RoboAaron/Jetson-Demo-Bot-Johnny-5/SUMMARY_FOR_EXPERTS.md

# Summary for Experts - Self-Balancing Robot Project

**Quick Reference:** Key findings and recommendations for expert review

---

## Critical Finding: Ground Fix Resolved All Issues

**Date:** January 2, 2025  
**Status:** ✅ **COMMUNICATION EXCELLENT** - Ready for PID Tuning

### Test Results (After Ground Fix)
- **VESC Communication:** 98-99% success rate (TARGET: >90%) ✅ **EXCEEDS TARGET**
- **IMU Communication:** 99-100% success rate (TARGET: >95%) ✅ **EXCEEDS TARGET**
- **Teensy Stability:** No resets ✓ (software fixes successful)
- **Velocity Data:** Reliable and reasonable (-5 to +5 m/s) ✅ **EXCELLENT**
- **Position Tracking:** Working correctly ✅ **FUNCTIONAL**

### Key Insight
**Missing shared ground was the root cause** - After adding shared ground connection between Teensy and VESCs, all communication issues resolved. No hardware fixes (ferrite beads, twisted wires) needed.

---

## System Architecture

- **Microcontroller:** Teensy 4.1 (600MHz ARM Cortex-M7)
- **IMU:** BNO085 @ 400kHz I2C, 400Hz updates
- **Motor Controllers:** Dual VESC 6 @ 115200 baud UART
- **Control:** Cascaded PID (500Hz control loop)
- **Power:** Separate supplies (Teensy USB, motors separate)

---

## What's Working

✅ System initializes correctly  
✅ IMU initializes and communicates (76-91% success)  
✅ VESCs initialize  
✅ PID controllers working  
✅ No Teensy resets (rate limiting fixed buffer overflow)  
✅ Software optimizations implemented

---

## What's Not Working

⚠️ **Motor aggressiveness:** Motors moving too aggressively (PID tuning needed)
- **Not a communication issue** - system is fully operational
- **Solution:** Reduce PID gains (Kp_angle, Kp_vel, maxCurrent)
- **Status:** Ready for tuning, not a blocker

---

## Required Actions

### ✅ COMPLETED
1. **Added shared ground** between Teensy and VESCs
2. **Verified communication** - 98-99% success rates achieved
3. **Confirmed system operational** - Ready for tuning

### Immediate: PID Tuning
1. **Reduce maxCurrent:** Press 'm' to reduce to 5.0-6.0A (currently 8.0A)
2. **Reduce Kp_angle:** Press 'p' to reduce to 10.0-12.0 (currently 15.0)
3. **Reduce Kp_vel:** Press 'P' to reduce to 0.5-0.6 (currently 0.8)
4. **Test on stand** - motors should be smoother
5. **Test on floor** - once motors are less aggressive

### Short-term: Balance Testing
- Once PID tuned, proceed to balance attempts
- Target: 70-85% success rate
- Monitor communication (should stay >95%)

---

## Questions for Experts

1. **Is 98-99% VESC success rate acceptable?** Should we expect 100%?
2. **PID tuning recommendations?** What gains for smooth, stable balance?
3. **Is 67Hz VESC rate appropriate?** Or should we go slower (50Hz) for smoother control?
4. **Motor aggressiveness:** Is this purely PID, or are there other factors?
5. **Should we consider CAN bus** for future improvements, or is UART sufficient?

---

## Full Documentation

- **EXPERT_REVIEW_DOCUMENT.md** - Complete technical review
- **BASELINE_TEST_RESULTS.md** - Detailed test data and analysis
- **VESC_COMMUNICATION_RESEARCH.md** - Community findings and best practices
- **MOTOR_POWER_RESET_TROUBLESHOOTING.md** - Hardware troubleshooting guide

---

**Bottom Line:** System architecture is sound, software is optimized, and **communication is excellent (98-99% success)** after adding shared ground. The system is operational and ready for PID tuning to reduce motor aggressiveness. No hardware fixes needed.
