RoboAaron/Jetson-Demo-Bot-Johnny-5/teensy_balance_single_loop/LAST_WORKING_CONFIG.md

# ⚠️ LAST WORKING CONFIGURATION - DO NOT MODIFY

## Status: EXCELLENT BALANCE PERFORMANCE ✅

**Date:** 2026-01-23 17:34:38  
**Log File:** `tuning_code/logs/robot_log_20260123_173438.txt`  
**Firmware:** `teensy_balance_single_loop/teensy_balance_single_loop.ino` (before yaw control interference)

---

## Performance Metrics

- **Roll Stability:** -0.25° to -0.7° (target: -0.7°) - **EXCELLENT** (±0.5°)
- **Motor Current:** -1.0A to +1.0A - **SMOOTH, CONTROLLED**
- **IMU Communication:** 97.7-98.8% success rate - **EXCELLENT**
- **No Oscillations:** Roll varies smoothly, no chattering
- **Response to Disturbances:** Smooth corrections in 1-2 seconds

**VERDICT:** ✅ **READY FOR VELOCITY CONTROL**

---

## Tuning Values (WORKING)

```
ROLL PID CONTROL (Balance):
  Kp: 1.50
  Ki: 0.00
  Kd: 0.03
  Base Angle Setpoint: -0.70°
  Drive Offset: 0.00°
  Active Setpoint: -0.70°

MOTOR CONTROL:
  Max Current: 6.50A
  Min Current: 0.30A
  Motor Direction Sign: 1.0

SYSTEM CONFIG:
  I2C Clock: 400 kHz
  IMU Rate: 400 Hz
  PID Rate: 500 Hz
  Control Mode: PID
```

---

## Yaw Control Status

**Yaw control was DISABLED (corrupted values = -nan, output = 0.00A)**

This is why balance worked perfectly - yaw control was not interfering.

---

## Key Differences from Current Broken Version

1. **Yaw Output:** 0.00A (disabled) vs 6.50A (maxed out, fighting balance)
2. **Yaw Control:** Disabled vs Enabled with aggressive gains
3. **Balance:** Stable vs Unstable (robot falling over)

---

## How to Restore This Configuration

1. **Disable yaw control:**
   ```cpp
   bool yawControlEnabled = false;  // Change from true to false
   ```

2. **Set yaw gains to 0:**
   ```cpp
   double Kp_yaw = 0.0;
   double Ki_yaw = 0.0;
   double Kd_yaw = 0.0;
   ```

3. **Or use the 'n' command** to toggle yaw control off

4. **Restore balance PID values:**
   ```cpp
   double Kp = 1.50;
   double Ki = 0.00;
   double Kd = 0.03;
   double baseSetpoint = -0.70;
   float maxCurrent = 6.50;
   ```

---

## Notes

- This configuration achieved **excellent balance performance**
- Robot balanced consistently on stand for 30+ seconds
- All readiness criteria were met
- **This is the baseline to build from for velocity control**

**DO NOT modify this configuration unless you have a specific reason and have tested thoroughly.**
