RoboAaron/Jetson-Demo-Bot-Johnny-5/teensy_balance_single_loop/READINESS_CHECKLIST.md

# Readiness Checklist: When to Add Velocity Control

## Quick Answer

**You need "Good Enough" stability, not perfection.** The angle PID should be **stable and responsive**, but it doesn't need to be perfectly tuned. You can fine-tune everything together once velocity control is added.

**Minimum Requirements**: ✅ All items in "Must Have" section  
**Recommended**: ✅ All items in "Must Have" + "Should Have" sections  
**Ideal**: ✅ All items (but not required to proceed)

---

## Must Have (Required Before Velocity Control)

### 1. ✅ Robot Balances on Stand
- **Test**: Place robot on stand, let go
- **Pass**: Robot holds position for **30+ seconds** without falling
- **Fail**: Robot falls over or requires constant intervention
- **Why**: If it can't balance in place, adding velocity will make it worse

### 2. ✅ Responds to Disturbances
- **Test**: Gently push robot forward/backward on stand
- **Pass**: Robot corrects and returns to upright within **2-3 seconds**
- **Fail**: Robot doesn't respond or oscillates wildly
- **Why**: Velocity control will add disturbances; robot must handle them

### 3. ✅ No Wild Oscillations
- **Test**: Watch roll angle in GUI while balanced
- **Pass**: Roll angle varies by **±2° or less** when stable
- **Fail**: Roll angle oscillates ±5°+ or motor current oscillates rapidly
- **Why**: Oscillations will amplify with velocity control

### 4. ✅ Smooth Motor Response
- **Test**: Watch motor current in GUI
- **Pass**: Current changes smoothly, no rapid on/off switching
- **Fail**: Current jumps between max/min rapidly (chattering)
- **Why**: Velocity control needs smooth base to work with

### 5. ✅ Correct Direction
- **Test**: Tilt robot forward → wheels spin forward
- **Pass**: Robot moves in correct direction when tilted
- **Fail**: Robot moves wrong direction
- **Why**: Wrong direction will cause instability

---

## Should Have (Recommended but Not Required)

### 6. ✅ Recovers from Large Tilts
- **Test**: Tilt robot 10-15° and release
- **Pass**: Robot recovers to upright within 3-5 seconds
- **Fail**: Robot can't recover or takes >10 seconds
- **Why**: Velocity control may cause larger tilts during acceleration

### 7. ✅ Stable Current When Balanced
- **Test**: Watch current when robot is upright
- **Pass**: Current stays below **2-3A** when stable
- **Fail**: Current stays high (>4A) even when balanced
- **Why**: High current indicates over-correction or wrong setpoint

### 8. ✅ Minimal Overshoot
- **Test**: Tilt robot and release
- **Pass**: Robot returns to upright with <2° overshoot
- **Fail**: Robot overshoots by 5°+ or oscillates
- **Why**: Overshoot will cause velocity control to over-correct

---

## Nice to Have (Optional)

### 9. ✅ Works on Floor
- **Test**: Balance robot on floor (with safety measures)
- **Pass**: Robot balances for 10+ seconds on floor
- **Fail**: Robot only works on stand
- **Why**: Floor balancing is harder; if it works, you're ready

### 10. ✅ Handles Yaw Rotation
- **Test**: Robot doesn't spin when balancing
- **Pass**: Yaw stays within ±5° when balancing
- **Fail**: Robot rotates continuously
- **Why**: Yaw control should be working before adding velocity

---

## What Happens If You Add Velocity Too Early?

### Scenario 1: Unstable Base (Fails "Must Have" #1-3)
**Result**: 
- Robot becomes completely unstable
- Velocity control amplifies existing oscillations
- Robot falls immediately when velocity command given
- **Solution**: Go back and fix angle PID first

### Scenario 2: Chattering Motors (Fails "Must Have" #4)
**Result**:
- Velocity control adds more chattering
- Motors oscillate between forward/backward rapidly
- Robot shakes violently
- **Solution**: Reduce angle PID gains, add more damping

### Scenario 3: Wrong Direction (Fails "Must Have" #5)
**Result**:
- Velocity commands make robot more unstable
- Robot accelerates in wrong direction
- Falls immediately
- **Solution**: Fix motor direction first

---

## Practical Test Protocol

### Test 1: Stand Stability (5 minutes)
1. Place robot on stand
2. Let go and observe for 30 seconds
3. **Pass if**: Robot stays upright, roll angle ±2°
4. **Fail if**: Robot falls or oscillates wildly

### Test 2: Disturbance Response (5 minutes)
1. Gently push robot forward
2. Release and observe recovery
3. **Pass if**: Returns to upright in 2-3 seconds
4. **Fail if**: Doesn't recover or oscillates

### Test 3: Motor Smoothness (2 minutes)
1. Watch GUI current graph
2. Observe while robot is balanced
3. **Pass if**: Current changes smoothly, no rapid switching
4. **Fail if**: Current jumps rapidly (chattering)

### Test 4: Direction Test (1 minute)
1. Tilt robot forward
2. Observe wheel direction
3. **Pass if**: Wheels spin forward
4. **Fail if**: Wheels spin backward

**Total Time**: ~15 minutes

---

## Current Status Assessment

Based on your recent testing:

### ✅ Likely Ready If:
- Robot balances on stand for 30+ seconds
- Yaw control is working (prevents rotation)
- Motor current is reasonable (<3A when stable)
- No major oscillations observed

### ⚠️ Needs More Tuning If:
- Robot falls over on stand
- Motor chattering observed
- Large oscillations (±5°+)
- Can't recover from small pushes

### ❌ Not Ready If:
- Robot doesn't balance at all
- Motors go wrong direction
- Wild oscillations or shaking
- Can't even hold position on stand

---

## The "Good Enough" Threshold

**Key Insight**: You don't need perfect tuning. You need:
1. **Stability**: Robot doesn't fall over
2. **Responsiveness**: Robot corrects disturbances
3. **Smoothness**: No wild oscillations

**Why "Good Enough" Works**:
- Velocity control will actually **help** stability (provides smooth acceleration)
- You can tune angle and velocity loops together
- Perfect angle tuning may not work well with velocity anyway
- Industry practice: Tune cascaded loops together, not separately

---

## Recommended Approach

### Option A: Conservative (Recommended)
1. Get angle PID stable on stand (30+ seconds)
2. Add velocity control with very low gains (Kp_vel = 0.1)
3. Tune both loops together
4. Gradually increase velocity gains

### Option B: Aggressive
1. Get angle PID "good enough" (15-20 seconds stable)
2. Add velocity control immediately
3. Tune everything together from the start

**Recommendation**: Option A is safer, but Option B can work if you're confident.

---

## What to Watch For After Adding Velocity

### Good Signs:
- Robot balances with velocity = 0
- Robot moves smoothly when velocity > 0
- No new oscillations introduced
- Recovery from disturbances still works

### Bad Signs:
- Robot becomes less stable than before
- New oscillations appear
- Can't balance even with velocity = 0
- Motors chatter more

**If Bad Signs**: Reduce velocity gains or go back to angle-only tuning

---

## Bottom Line

**Minimum to Proceed**:
- ✅ Robot balances on stand (30+ seconds)
- ✅ Responds to disturbances
- ✅ No wild oscillations
- ✅ Smooth motor response
- ✅ Correct direction

**You DON'T need**:
- ❌ Perfect floor balancing
- ❌ Zero overshoot
- ❌ Perfect setpoint
- ❌ Optimal gains

**Time Estimate**:
- If robot is already balancing: **Ready now** ✅
- If needs tuning: **1-2 hours** to get to "good enough"
- If major issues: **4-6 hours** to fix fundamentals

---

## Next Steps

1. **Run the 4 tests above** (15 minutes)
2. **If all pass**: You're ready for Phase 1 (Velocity Control)
3. **If some fail**: Fix those issues first (1-2 hours)
4. **If many fail**: Go back to basics (4-6 hours)

**Remember**: "Good enough" is good enough. You can always tune more later!
