RoboAaron/Jetson-Demo-Bot-Johnny-5/docs/delivery/4/4-10.md

# [4-10] Traction Surface Retune + Optional Plant ID

**Parent**: [Tasks for PBI 4](./tasks.md)

## Description

Re-run Phase A tuning on a representative high-traction floor (not cardboard). Optionally log commanded motor current vs wheel ERPM / derived acceleration for a simple static/dynamic friction and thrust map to inform `maxCurrent` and velocity-loop limits.

## Status History

- 2026-04-16: Created as **Proposed** (roadmap Phase C).

## Requirements

1. Document test surface and date in log filename or header note.
2. Establish safe `maxCurrent` for that surface without chronic wheel slip.
3. Optional: short script or checklist for step-response logging at 0.5 / 1.0 / 1.5 / 2.0 A.

## Implementation Plan

Operator-led tuning; firmware changes only if new telemetry fields are needed.

## Test Plan

30 s quiet hold + impulse recovery on target surface; compare to cardboard baseline.

## Verification

Pending.

## Files Modified

None expected unless telemetry added.
