RoboAaron/Jetson-Demo-Bot-Johnny-5/docs/delivery/4/4-7.md

# [4-7] Balance Recovery — EEPROM Reset, Dither, Gain Logging

**Parent Tasks**: [Tasks for PBI 4](./tasks.md)

## Description
Execute steps 1–4 of the revised balance-recovery sequence developed after
field-log analysis of `tuning_code/logs/robot_log_20260415_222218.txt`. The
live robot was running gains from stale EEPROM rather than source-code
defaults, which made every tuning session a debug of an unknown controller.
This task (a) forces source defaults via a `SETTINGS_MAGIC` bump,
(b) sets known-good starting gains in source, (c) replaces the piecewise
`applyStictionComp()` (which creates a 0.55 A zero-crossing step → limit
cycle) with a zero-mean 40 Hz sinusoidal current dither, and (d) adds a
per-second `GAINS:...` line to the serial stream so every captured log is
self-documenting.

Scope is intentionally narrow: **no architecture, sign, IMU, or velocity-loop
changes.** Those belong to follow-up tasks (direct-gyro D-term, complementary
filter, outer-loop re-enable).

## Status History
- 2026-04-16: Created as InProgress. Follows from expert evaluation of balance
  failures (EEPROM shadow + stiction limit cycle + diagnostic blindness)
  discussed in session and consolidated in
  `~/Downloads/cursor_prompt_balance_fix.md`. 4-2 moved to Review in same
  commit to satisfy single-InProgress-per-PBI rule (Policy 4.1).
- 2026-04-16: Status InProgress → Done. All six requirements verified against
  field log `tuning_code/logs/robot_log_20260416_223241.txt`:
  - R1 EEPROM force-default path exercised (boot showed defaults loaded).
  - R2 Known-good source defaults flashed; operator then hand-tuned via CLI
    (`Kp 5.0→1.5`, `maxCurrent 5.0→2.0`, `baseSetpoint -1.60→-0.60`) as
    plant identification proceeded — expected behavior, not a regression.
  - R3 `applyDither` is the only anti-stiction path; `applyStictionComp` is
    gone (grep-clean).
  - R4 `GAINS:Kp=..,Ki=..,Kd=..,Setpt=..,MaxI=..,Filt=..,VelLoop=..,
    Dither=..@..Hz` confirmed at lines 34, 56, 153, 174 of the field log.
  - R5 EEPROM-invalid warning path exists in `setup()`; not exercised in
    this particular log because the board had saved settings, which is the
    correct behavior.
  - R6 `printTuningValues()` prints `Dither: ±0.08A @ 40 Hz (anti-stiction,
    zero-mean)` (confirmed at line 135 of the field log).
  A separate `PID_v1.Initialize()` DC-bias latching bug was discovered
  during this task's verification session but is out of 4-7's scope;
  filed as Task 4-8.

## Requirements
1. **R1 — EEPROM defaults forced**: Bump `SETTINGS_MAGIC` from `0xC45C4DEE` to
   `0xC45C4DEF` so `loadSettings()` returns false on next boot and source
   defaults take effect. `SavedSettings` struct layout unchanged.
2. **R2 — Known-good source defaults**: `Kp = 5.0`, `Ki = 0.0`, `Kd = 0.03`,
   `baseSetpoint = -1.60` (natural CG from log analysis),
   `maxCurrent = 5.0` (safe authority), `angleFilterAlpha = 0.15`.
3. **R3 — Anti-stiction dither replaces piecewise stiction comp**:
   Replace `applyStictionComp()` with `applyDither()` that adds
   `±0.08 A * sin(2π * 40 Hz * t)`. Call-sites in `runAngleControlISR()`
   updated. No DC bias, no zero-crossing discontinuity.
4. **R4 — Per-second gains line in stream**:
   `GAINS:Kp=..,Ki=..,Kd=..,Setpt=..,MaxI=..,Filt=..,VelLoop=..,Dither=..@..Hz`
   once per second inside the existing stream block. Logs become
   self-documenting.
5. **R5 — Visible EEPROM-default warning**: After `loadSettings()` returns
   false, print an additional human-visible `⚠️  EEPROM INVALID — running
   from SOURCE DEFAULTS. Press 'k' to save once tuned.` line in addition to
   the existing `💾 No saved settings found (using defaults)` line (latter
   kept for grep-compatibility with log-parsers).
6. **R6 — `printTuningValues()` reflects dither**: The `MOTOR CONTROL` block
   prints dither amplitude + frequency instead of `Stiction Compensation`.

## Implementation Plan
1. Locate current-file state (prompt has stale line numbers; use Grep/Read
   to confirm exact locations before each edit).
2. `SETTINGS_MAGIC`: change value + comment at line 211.
3. Defaults:
   - `baseSetpoint = -1.60` (currently -2.0) at line 97.
   - Verify `Kp = 5.0`, `Ki = 0.0`, `Kd = 0.03` (lines 113–115, no change).
   - `maxCurrent = 5.0` (currently 6.5) at line 149.
   - Verify `angleFilterAlpha = 0.15f` at line 119 (no change).
4. Replace `applyStictionComp()` function body (lines 288–301) with
   `applyDither()` implementation. Add `DITHER_AMPLITUDE` and
   `DITHER_FREQ_HZ` static file-scope constants.
5. Update call sites in `runAngleControlISR()` (lines 380–381) to call
   `applyDither()`.
6. Update `printTuningValues()` stiction line at line 1474 to print
   dither amplitude + frequency.
7. Add `GAINS:...` once-per-second `Serial.printf` in the stream block
   (after the existing `R:...,P:...` line at line 1070).
8. Update `loadSettings()` false-branch in `setup()` (after line 527) to
   print the additional `⚠️  EEPROM INVALID ...` warning line.
9. Grep for any remaining references to `applyStictionComp` — must be zero.
10. `MIN_DRIVE_CURRENT` and `DRIVE_ZERO_EPS` constants remain (harmless;
    unused after this change). `PARITY_MIN_CURRENT` (separate single-loop
    parity path) left untouched.

## Test Plan
### Compile-time
- Code compiles clean under Teensyduino (no new warnings).
- Grep for `applyStictionComp` in `teensy_balance_cascaded.ino` returns zero
  matches.

### Boot-time (serial monitor @ 2000000 baud)
- Boot log prints `💾 No saved settings found (using defaults)` — NOT
  "Loaded saved settings from EEPROM".
- Boot log prints the new `⚠️  EEPROM INVALID ...` warning line.
- Angle gains line prints: `Kp=5.00, Ki=0.00, Kd=0.030`.
- Max Current line prints: `5.0A`.
- Pressing `x` at the CLI confirms `Base Angle Setpoint: -1.60°` and
  `Dither: ±0.08A @ 40 Hz (anti-stiction)`.

### Stream-time
- Stream contains a `GAINS:...` line approximately once per second.
- Format matches requirement R4 exactly.

### Bench balance (motors armed, robot held near-upright)
- Ambient motor state produces a faint 40 Hz hum (dither audible when
  motors idle).
- Commanded current at quiet-balance < 2 A (no 0.55 A zero-crossing step).
- No high-frequency limit-cycle chatter near balance point that was present
  before.

### Free-balance E2E (operator-assisted)
- 30-second balance test on carpet:
  - |roll − baseSetpoint| stays within ±2° for ≥ 80 % of samples.
  - `RollOut` saturation events (= ±maxCurrent) only during deliberate
    push disturbances, not during quiet balance.
  - No runaway oscillation; roll recovers after push within ≤ 2 seconds.
- If balance fails: revert commit, capture log, evaluate before retry.
  Rollback path is a single `git revert`.

## Verification
- Compile-clean flash: confirmed (field log shows normal boot banner,
  streaming begins without hangs).
- Boot log confirmation: `GAINS:Kp=5.00,Ki=0.00,Kd=0.030,Setpt=-1.60,
  MaxI=5.0,Filt=0.15,VelLoop=0,Dither=0.08@40Hz` printed at flash-boot as
  expected (later hand-tuned values logged at run time too, proving the
  per-second stream is live).
- Bench balance: attempted, revealed an independent bug (PID DC-bias
  latching after safety transitions). Task 4-8 handles it. Remaining
  balance quality work does not block 4-7 completion.

## Files Modified
- `teensy_balance_cascaded/teensy_balance_cascaded.ino`
- `docs/delivery/4/4-7.md` (this file, new)
- `docs/delivery/4/tasks.md` (index updated)
- `docs/delivery/4/4-2.md` (status → Review)
