RoboAaron/Jetson-Demo-Bot-Johnny-5/docs/delivery/4/4-2.md

# [4-2] Fix Velocity Loop Sign and Deadband Issues

## Description
Fix critical issues in the cascaded velocity control loop: incorrect PID sign causing positive feedback, deadband logic thrashing PID modes, and missing input clamping.

## Status History
- 2026-01-26: Created as InProgress - fixing velocity loop sign and deadband mode thrashing
- 2026-02: Velocity sign verified correct for our VESC (no VEL SIGN MISMATCH). Deadband thrashing fixed via state flag (see TUNING_RECOMMENDATIONS.md "Deadband thrashing (fixed)").
- 2026-04-15: Extended scope to implement Phase 1 Step 2 from `velocity_estimation_plan.pdf` (IMU pitch-rate velocity estimator routed to velocity PID input). Task remains InProgress.
- 2026-04-15: Extended scope to cover BNO085 reboot/power-cycle recovery. Field logs showed full-rate updates after flash boot, but reboot/power-cycle fell into a weaker `wasReset()` recovery path that only re-enabled reports and produced much slower effective update delivery. Recovery now re-applies report configuration after `wasReset()` with the same settle + second-enable timing as startup, without calling `begin_I2C()` from `loop()` (which can strand I2C). The startup `ignoreNextImuReset` path must also re-enable reports: consuming `wasReset()` alone drops subscriptions until `enableReport` runs again.
- 2026-04-16: Status InProgress → Review. All requirements met: velocity PID sign correct (REVERSE + verification print), deadband mode thrashing fixed (state flag), input clamping added, debug print sign corrected, BNO085 reboot/power-cycle recovery verified working. Remaining inner-loop EEPROM-gain-shadow problem and stiction-comp limit-cycle are not part of this task's scope; moved to new Task 4-7 (Balance Recovery). Pending final operator verification on a full balance session before Review → Done.

## Requirements
1. **Fix Velocity PID Sign**: Change from DIRECT to REVERSE mode to correct control direction
2. **Fix Deadband Mode Thrashing**: Stop toggling MANUAL/AUTOMATIC every 50ms - use state flag
3. **Add Input Clamping**: Clamp velocityInput to prevent garbage values from saturating loop
4. **Fix Debug Print Sign**: Correct velocity error calculation (setpoint - input, not input - setpoint)
5. **Add Sign Verification Print**: Clear debug output to verify correct behavior after fix
6. **Fix Reboot/Power-Cycle IMU Recovery**: After `wasReset()`, restore the same full-rate BNO085 startup behavior seen after flash upload

## Implementation Plan
1. Change velocity PID initialization from `DIRECT` to `REVERSE`
2. Add `static bool deadbandActive = false;` state flag
3. Replace deadband block with state-based logic:
   - Enter deadband once: Set MANUAL mode, zero output
   - Exit deadband once: Set AUTOMATIC mode, re-initialize
4. Add `velocityInput = constrain(velocityInput, -2.0, 2.0);` before Compute()
5. Fix debug print: `float velocityError = velocitySetpoint - filteredVelocity;`
6. Add sign verification print at 1Hz showing setpoint, filteredVelocity, angleFromVel
7. On every `wasReset()` (including the expected post-startup reset), call `enableIMUReports()` again after delays so SH2_RESET does not leave the hub with no rotation-vector subscription; do not call `begin_I2C()` from `loop()`

**How deadband thrashing is fixed:** Thrashing happened when the code toggled MANUAL/AUTOMATIC every 20 ms based on whether we were inside or outside the velocity deadband, which reset the PID integral and caused unstable behavior. The fix is to **transition only once** in each direction: when we first enter deadband (setpoint ≈ 0 and |velocity| < 0.08 m/s), set `deadbandActive = true`, call `SetMode(MANUAL)`, and zero the angle-from-velocity output; while in deadband do not call the PID. When we leave (setpoint non-zero or velocity outside deadband), set `deadbandActive = false` and `SetMode(AUTOMATIC)` once, then run the velocity PID as normal. See `teensy_balance_cascaded/TUNING_RECOMMENDATIONS.md` section "Deadband thrashing (fixed)" and firmware around the 20 Hz velocity PID block.

## Plan Change Log (Velocity Estimation Plan vs Implementation)

### Applied from plan
1. Added IMU velocity estimator path (Option A): pitch-rate integration with decay and clamping.
2. Routed outer-loop `velocityInput` from IMU estimate (replacing VESC-derived filtered velocity for control).
3. Added runtime `VEL_SCALE` tuning commands (`n`/`N`) for live scale calibration.
4. Kept VESC reads in background for diagnostics and comparison.

### Deviations from original plan and rationale
1. **Gyro rate reduced from 400Hz to 100Hz** (`GYRO_REPORT_INTERVAL_US = 10000`):
   - Rationale: reduced I2C bus pressure and improved startup robustness observed in-field.
2. **`dt` sanity window widened from `<0.01` to `<0.03` seconds** in estimator:
   - Rationale: at 100Hz, nominal sample period is ~0.01s and can jitter above 10ms; strict `<0.01` would drop valid updates.
3. **VESC signal kept visible in debug prints while control uses IMU velocity**:
   - Rationale: enables side-by-side validation and rollback confidence without reintroducing VESC noise into the control path.
4. **Motor command dispatch remains outside ISR** (prior structural change retained):
   - Rationale: avoids UART write contention and streaming stalls discovered during previous ISR-based write attempts.
5. **`wasReset()` recovery re-applies report configuration (double enable with settle delays), not `begin_I2C()` in `loop()`**:
   - Rationale: after `SH2_RESET`, report subscriptions are cleared; the code must call `enableReport` again or no rotation vectors arrive (`imuReadCount` stays 0). A brief attempt to run `begin_I2C()` from `loop()` after a bad `wasReset()` handling caused I2C probe failures (`I2C address not found`). The fix is to keep the SHTP session open and only re-send sensor config, matching startup timing without an extra transport teardown in `loop()`.

## Test Plan
1. **Sign Verification**: With velocitySetpoint = 0, angleSetpointFromVel should sit at ~0 (no constant +0.5° saturation)
2. **Positive Velocity**: Command +velocity, verify angleFromVel moves in direction that reduces (setpoint - velocity) error
3. **Deadband Stability**: Verify PID mode doesn't toggle constantly when in deadband
4. **Input Clamping**: Verify garbage velocity values don't cause instant saturation
5. **Reboot Recovery**: After hardware reset or power cycle, verify `wasReset()` paths print re-enable success and status lines resume at the normal ~50 ms stream cadence rather than multi-second gaps; confirm no `I2C address not found` after flash boot

## Verification
- Velocity loop responds correctly to setpoint changes
- No mode thrashing in deadband
- Input values stay within reasonable bounds
- Debug output shows correct signs
- Reboot/power-cycle: `wasReset()` always re-enables reports (including startup-ack path); no `begin_I2C()` from `loop()`

## Files Modified
- `teensy_balance_cascaded/teensy_balance_cascaded.ino`
- `docs/delivery/4/4-2.md`

**Parent Tasks**: [Tasks for PBI 4](./tasks.md)
