RoboAaron/Jetson-Demo-Bot-Johnny-5/docs/delivery/4/4-4.md

# [4-4] Implement Sensor Fusion

## Description
Improve angle estimation by fusing IMU data (e.g. complementary filter or Kalman) on the Teensy, if needed. BNO085 already provides onboard fusion; this task is for any additional fusion (e.g. with VESC velocity) or if switching to raw gyro/accel is desired.

## Status History
- 2026-02: Task file created; scope from PBI-4 prd.

## Requirements
1. Assess whether BNO085 fused output is sufficient (current: 400 Hz I2C).
2. If improved fusion is needed: implement complementary or Kalman filter combining gyro and accel (or BNO085 output with velocity) per BALANCE_CODE_REVIEW and literature.
3. Document fusion choice and parameters.

## Implementation Plan
1. Review current BNO085 usage and PATH_TO_99_PERCENT_RELIABILITY.md.
2. If proceeding: add filter in firmware; tune; compare balance stability vs current.
3. Document in firmware and/or docs.

## Test Plan
1. Compare balance stability and drift with/without new fusion.
2. Log roll variance and recovery time.

## Verification
- Angle estimate stable and low drift; no regression in balance success.
- Documented in PBI-4 prd and firmware.

## Files Modified
- `teensy_balance_cascaded/teensy_balance_cascaded.ino` (if implemented)
- Docs as needed

**Parent**: [Tasks for PBI 4](./tasks.md)
