RoboAaron/Jetson-Demo-Bot-Johnny-5/docs/delivery/4/4-E2E.md

# [4-E2E] E2E CoS Test for PBI-4

## Description
End-to-end verification that PBI-4 Conditions of Satisfaction are met: stable balance, velocity control without breaking balance, and documented tuning and test results. No SPI dependency.

## Status History
- 2026-02: Task file created; scope from PBI-4 tasks index.

## Requirements
1. **Phase 1 cascaded control**: Balance with velocity setpoint 0 is stable; velocity loop can be used without breaking balance (per PBI-4 CoS).
2. **Velocity loop**: Sign and deadband issues resolved (4-2); tuning stable (4-3).
3. **Testing**: 4-6 completed; results documented.
4. **Optional**: Sensor fusion (4-4), velocity damping (4-5) if in scope for this release.

## Implementation Plan
1. Run full test suite from 4-6.
2. Confirm all PBI-4 CoS from backlog/prd are either met or explicitly deferred.
3. Sign off E2E: balance stable, velocity control functional, docs updated.

## Test Plan
1. Execute 4-6 test matrix.
2. Review log_evaluator outputs and baseline docs.
3. Confirm no VEL SIGN MISMATCH when wheels moving (or explain and accept).
4. Confirm CoS checklist in prd.md.

## Verification
- PBI-4 CoS checklist completed; E2E pass/fail recorded in task or prd history.

## Files Modified
- `docs/delivery/4/prd.md` (CoS / history)
- Test result docs

**Parent**: [Tasks for PBI 4](./tasks.md)
