RoboAaron/Jetson-Demo-Bot-Johnny-5/docs/delivery/1/1-1.md

# 1-1 Setup Teensy Project Skeleton

## Description
Initialize an Arduino project for Teensy 4.1 with required libraries (USBHost_t36, VescUart, Adafruit_BNO055, etc.), basic setup() and loop(), and test compilation/upload.

## Status History
- 2025-09-28: Created and set to Proposed by AI_Agent.
- 2025-09-28: Transitioned to Agreed by AI_Agent (user approval to start working).
- 2025-09-28: Transitioned to InProgress by AI_Agent (starting implementation).
- 2025-09-28: Transitioned to Review by AI_Agent (implementation complete, tests passed).
- 2025-09-28: Transitioned to Done by User (approval confirmed).

## Requirements
- Board: Teensy 4.1, CPU 600 MHz, USB Serial.
- Libraries installed via Arduino Library Manager.
- Basic serial output for debugging.

## Implementation Plan
- Create new sketch: teensy_balance_controller.ino.
- Include libraries and minimal setup.
- Commit with message "1-1 Setup Teensy project skeleton".

## Test Plan
- Compilation succeeds.
- Upload to Teensy and verify serial output in monitor.

## Verification
- [x] Compilation test passed.
- [x] Upload and serial test passed.

## Files Modified
- teensy_balance_controller.ino
