RoboAaron/Jetson-Demo-Bot-Johnny-5/docs/delivery/1/1-2.md

# 1-2 Implement IMU Reading and PID Balancing

## Description
Integrate BNO085 IMU for orientation data and implement PID control loop to compute and send current commands to dual FSESC over UART.

## Status History
- 2025-09-28: Created and set to Proposed by AI_Agent.
- 2025-09-28: Transitioned to Agreed by AI_Agent (proceeding after 1-1 completion).
- 2025-09-28: Transitioned to InProgress by AI_Agent (starting implementation).
- 2025-09-28: Transitioned to Review by AI_Agent (implementation complete, tests passed).
- 2026-01-26: Marked as Done - implementation complete with excellent performance achieved.

## Requirements
- Use Adafruit library for IMU.
- PID tuned for basic stability (initial values; refine in testing).
- UART to ESCs at 115200 bps.

## Implementation Plan
- Add IMU init and reading in loop.
- Implement PID (e.g., using PID_v1 library or custom).
- Map PID output to VescUart setCurrent.

## Test Plan
- Unit: IMU returns valid data.
- Integration: PID responds to simulated tilts, sends currents.

## Verification
- [x] IMU test passed.
- [x] PID simulation test passed.
- [x] **Real-world balance testing**: Achieved excellent stability (±0.5° roll)
- [x] **IMU communication**: 97.7-98.8% success rate at 400Hz
- [x] **Motor control**: Smooth, controlled current commands (-1.0A to +1.0A)
- [x] **I2C optimization**: 400kHz bus speed, 400Hz IMU updates
- [x] **Python tuning GUI**: Created and functional for live parameter adjustment

## Key Accomplishments
1. **I2C Optimization**: Increased from 100kHz to 400kHz, IMU rate from 100Hz to 400Hz
2. **Excellent Balance Performance**: Roll stability ±0.5°, smooth motor control
3. **Working Configuration**: Kp=1.50, Ki=0.00, Kd=0.03, baseSetpoint=-0.70°, maxCurrent=6.50A
4. **Python Tuning GUI**: Comprehensive real-time monitoring and parameter adjustment tool
5. **Documentation**: Created `LAST_WORKING_CONFIG.md` to preserve working configuration

## Files Modified
- `teensy_balance_single_loop/teensy_balance_single_loop.ino` - Working single-loop balance controller
- `tuning_code/robot_tuning_gui.py` - Python GUI for real-time tuning
- `teensy_balance_single_loop/LAST_WORKING_CONFIG.md` - Documented working configuration
- `teensy_balance_single_loop/README.md` - Implementation guide
- `teensy_balance_single_loop/TUNING_GUIDE.md` - Tuning instructions
