RoboAaron/Jetson-Demo-Bot-Johnny-5/docs/delivery/1/1-3.md

# 1-3 Implement USB Serial Interface with Jetson

## Description
Add high-speed USB serial communication to send IMU data to Jetson and receive velocity/steering commands.

## Status History
- 2025-09-28: Created and set to Proposed by AI_Agent.

## Requirements
- Baud rate: 2000000 bps.
- Simple packet protocol (e.g., delimited strings with checksum).

## Implementation Plan
- Use Serial for USB comms.
- In loop: Send pitch/roll; parse incoming commands.
- Blend received velocity into PID setpoint.

## Test Plan
- Send/receive test packets via serial monitor or Jetson script.

## Verification
- [ ] Bidirectional comms test passed.

## Files Modified
- teensy_balance_controller.ino
