RoboAaron/Jetson-Demo-Bot-Johnny-5/docs/delivery/1/1-4.md

# 1-4 Integrate PS3 Remote Control

## Description
Add wireless PS3 controller input per teensy_gamepad_to_vesc_guide.md, mapping axes to motor currents with deadband, expo, and failsafe.

## Status History
- 2025-09-28: Created and set to Proposed by AI_Agent.

## Requirements
- Use USBHost_t36 for Bluetooth dongle.
- Map left/right Y axes to left/right currents.

## Implementation Plan
- Include USBHost_t36 and setup JoystickController.
- In loop: Read axes, apply mapping, set currents if connected.

## Test Plan
- Verify controller pairing and axis reading.
- Test movement response.

## Verification
- [ ] Pairing and input test passed.

## Files Modified
- teensy_balance_controller.ino
