RoboAaron/Jetson-Demo-Bot-Johnny-5/docs/delivery/1/1-5.md

# 1-5 Mode Blending and Integration

## Description
Implement logic to blend inputs from PID balancing, PS3 remote, and Jetson commands; add failsafes for disconnects.

## Status History
- 2025-09-28: Created and set to Proposed by AI_Agent.

## Requirements
- Priority: Jetson > PS3 > Autonomous balancing.
- Failsafe: Zero current on timeouts.

## Implementation Plan
- Add state machine for modes.
- Blend setpoints accordingly.

## Test Plan
- Simulate mode switches and verify smooth transitions.

## Verification
- [ ] Blending test passed.

## Files Modified
- teensy_balance_controller.ino
