RoboAaron/Jetson-Demo-Bot-Johnny-5/docs/delivery/11/prd.md

# PBI-11: Demo 4 - Object Recognition + Manipulation

## Overview
Implement Demo 4: Object Recognition + Manipulation so the robot can identify objects and interact with them (if manipulator hardware exists).

## Problem Statement
The robot should be able to recognize objects in its environment and interact with them, either through manipulation (if hardware exists) or through approach/tracking behaviors.

## User Stories
- As a user, I want the robot to recognize objects, so that it can identify items in its environment.
- As a user, I want the robot to interact with objects, so that it can perform useful tasks.

## Technical Approach
- Implement object detection using OAK-D Pro camera.
- Create object recognition pipeline (classification/identification).
- If manipulator exists: implement manipulation planning and execution.
- If no manipulator: implement object tracking and approach behaviors.
- Test object recognition accuracy and manipulation success rate.
- Document object recognition models and manipulation capabilities.

## UX/UI Considerations
- Object visualization: display of detected objects.
- Manipulation feedback: status of manipulation attempts.

## Acceptance Criteria
- Object detection identifies objects reliably.
- Object recognition classifies objects correctly.
- Manipulation or approach behaviors work as designed.
- Recognition accuracy >85% for target objects.
- Manipulation success rate >80% (if manipulator exists).
- All CoS from backlog met.

## Physical Robot Changes
- **OAK-D Pro camera**: Uses same camera mounting as PBI 8 (Vision-Driven Autonomy).
  - If PBI 8 not completed: Mount OAK-D Pro camera per PBI 8 specifications.
  - Camera orientation: Forward-facing for object detection.
- **Manipulator mounting** (if manipulation features implemented):
  - Mount manipulator arm on robot (location TBD based on design).
  - Cable routing: Power and control cables from manipulator to Jetson/Teensy.
  - Power: Manipulator power requirements (may need separate power supply).
- **No wiring changes to Teensy** (unless manipulator requires Teensy control).
- **Physical testing**: Requires robot to approach and interact with objects in physical space.

## Dependencies
- OAK-D Pro camera hardware.
- Manipulator hardware (if manipulation features implemented).
- PBI 8 (Vision-Driven Autonomy) - may share perception infrastructure.
- PBI 6 (Aluminum Chassis Build) - manipulator mounting depends on chassis design.

## Open Questions
- Which objects to recognize: define target object set.
- Manipulator hardware: does manipulator exist or focus on approach behaviors?
- Manipulator mounting location: upper deck vs forward mount (affects reach and stability).

## Related Tasks
See [Tasks for PBI 11](./tasks.md) (to be created)

**Parent Backlog**: [Backlog.md](../backlog.md)
