RoboAaron/Jetson-Demo-Bot-Johnny-5/docs/delivery/4/4-1.md

# [4-1] Implement Cascaded Velocity Control (Phase 1)

## Description
Add velocity control loop (outer loop) to working single-loop balance controller, enabling controlled forward/backward movement while maintaining balance.

## Status History
- 2026-01-26: Created and marked as Review - Phase 1 implementation completed
- 2026-01-26: Implementation complete with stability features, sign issues identified
- 2026-01-28: Motor direction fix — RIGHT_MOTOR_DIRECTION_SIGN and RIGHT_VELOCITY_SIGN set to -1.0 so both wheels spin same direction for balance (wheels were spinning opposite)
- 2026-01-28: Verified — wheels now spin same direction when balancing

## Requirements
1. Read VESC encoder RPM and convert to velocity (m/s)
2. Implement velocity PID controller (outer loop)
3. Integrate velocity loop output with angle setpoint
4. Add velocity control commands (v/V, 0, w/W, e/E, r/R)
5. Update serial output to include velocity data
6. Implement stability features: EMA filter, deadband, output clamping, slew rate limiting

## Implementation Plan
1. Add VESC encoder reading with rate limiting (15ms = 67Hz)
2. Convert ERPM to mechanical RPM, then to m/s
3. Create velocity PID controller (20Hz update rate)
4. Apply EMA filter to velocity measurements
5. Integrate angleSetpointFromVel with baseSetpoint
6. Add serial commands for velocity control and tuning
7. Update printTuningValues() and data stream

## Test Plan
1. Verify balance still works with velocitySetpoint = 0.0
2. Test velocity control with small setpoint (0.1 m/s)
3. Verify velocity loop stability features work correctly
4. Test tuning commands update gains correctly

## Verification
- ✅ VESC encoder reading implemented (ERPM→mechanical RPM→m/s conversion)
- ✅ Velocity PID controller created (20Hz, PI-only, Kd_vel always 0)
- ✅ EMA filter (α=0.1), deadband (0.08 m/s), clamping (±0.5°), slew rate (0.05°/update) implemented
- ✅ Serial commands added (v/V, 0, w/W, e/E, r/R, q/Q for minCurrent)
- ✅ Serial output updated with velocity data (Vel, VelSet, VelPID in data stream)
- ✅ Python GUI updated for velocity control UI
- ✅ Motor direction configured and verified: RIGHT_MOTOR_DIRECTION_SIGN = -1.0, RIGHT_VELOCITY_SIGN = -1.0 (wheels now spin same direction for balance; see docs/hardware/motor_direction_configuration.md)
- ⚠️ Sign issues identified - velocity PID in DIRECT mode causing positive feedback (Task 4-2)
- ⚠️ Deadband mode thrashing - MANUAL/AUTOMATIC toggling every 50ms (Task 4-2)
- ⚠️ Input clamping missing - garbage velocity values can saturate loop (Task 4-2)

## Key Learnings
1. **Motor Poles**: Corrected to 30 poles (15 pole pairs) for ERPM→RPM conversion
2. **Velocity Calculation**: `mech_rpm = erpm / pole_pairs`, then `mps = mech_rpm * π * wheel_diameter / 60`
3. **Stability Features**: EMA filter, deadband, clamping, and slew rate are essential for stable velocity loop
4. **Sign Verification**: Velocity PID direction must be REVERSE (not DIRECT) for correct control
5. **Deadband Handling**: State flag needed to prevent mode thrashing

## Files Modified
- `teensy_balance_cascaded/teensy_balance_cascaded.ino` - Created; motor direction signs updated 2026-01-28
- `tuning_code/robot_tuning_gui.py` - Updated for velocity control UI
- `teensy_balance_cascaded/README.md` - Created
- `teensy_balance_cascaded/PHASE1_IMPLEMENTATION.md` - Created
- `teensy_balance_cascaded/VELOCITY_LOOP_STABILITY_PATCH.md` - Created

**Parent Tasks**: [Tasks for PBI 4](./tasks.md)
