RoboAaron/Jetson-Demo-Bot-Johnny-5/docs/delivery/7/prd.md

# PBI-7: Isaac Sim Modeling and Simulation

## Overview
Create Isaac Sim models and simulations of the robot so control algorithms, designs, and autonomy features can be tested and validated in a safe virtual environment before deploying to hardware.

## Problem Statement
Testing on physical hardware is time-consuming, risky, and limited. Simulation allows rapid iteration, safe testing of edge cases, and algorithm development without hardware constraints.

## User Stories
- As a developer, I want robot simulation in Isaac Sim, so that I can test control algorithms safely.
- As a developer, I want validated simulation models, so that simulation results match real robot behavior.

## Technical Approach
- Create robot URDF/SDF model with accurate dimensions, mass properties, and joint configurations.
- Model sensors (IMU, camera, lidar) in Isaac Sim.
- Implement physics simulation with proper motor models and dynamics.
- Create simulation scenarios matching real-world test conditions.
- Validate simulation matches real robot behavior (tuning parameters).
- Use simulation for control algorithm development and testing.
- Document simulation setup and validation results.

## UX/UI Considerations
- Simulation visualization: clear view of robot state and sensor data.
- Parameter tuning: easy adjustment of simulation parameters.

## Acceptance Criteria
- URDF/SDF model created with accurate robot properties.
- Sensors modeled in simulation (IMU, camera, lidar).
- Physics simulation matches real robot dynamics (validated).
- Test scenarios created matching real-world conditions.
- Simulation used for algorithm development.
- All CoS from backlog met.

## Dependencies
- Robot design specifications (dimensions, mass, inertia).
- Isaac Sim installed and configured.
- Understanding of robot dynamics and sensor characteristics.

## Open Questions
- Level of detail required for simulation (simplified vs high-fidelity).
- Simulation validation methodology (how to match real behavior).

## Related Tasks
See [Tasks for PBI 7](./tasks.md) (to be created)

**Parent Backlog**: [Backlog.md](../backlog.md)
