RoboAaron/Jetson-Demo-Bot-Johnny-5/docs/delivery/4/4-6.md

# [4-6] Comprehensive Testing and Validation

## Description
Test balance and velocity control across scenarios (smooth floor, disturbances, duration) to validate stability and document results. Supports PBI-4 acceptance criteria and BALANCE_CODE_REVIEW performance expectations.

## Status History
- 2026-02: Task file created; scope from PBI-4 prd.

## Requirements
1. **Scenarios**: Smooth floor baseline; small and medium pushes; 30+ s continuous balance; optional incline/surface variation.
2. **Data**: Use tuning GUI logging; run log_evaluator.py on each run; record success/failure and duration.
3. **Documentation**: Update BASELINE_TEST_RESULTS or equivalent with scenario, config, and outcome.
4. **Goal**: Demonstrate stable balance with velocity setpoint 0; then safe use of velocity setpoint; no regression from single-loop baseline.

## Implementation Plan
1. Define test matrix (scenarios, number of runs, pass criteria).
2. Execute tests per TUNING_RECOMMENDATIONS and BALANCE_REVIEW_ACTIONS order.
3. Collect logs; run log_evaluator; summarize in docs.
4. Iterate on 4-2/4-3 if results show sign or tuning issues.

## Test Plan
1. Stand test: VEL SIGN MISMATCH count, roll/error stats.
2. Floor balance: 10 attempts × 30 s; record success rate and notes.
3. Disturbance: 5° and 10° push; record recovery time and overshoot.
4. Velocity: slow forward/back; no fall or sustained oscillation.

## Verification
- Test matrix completed; results documented; pass criteria met or gaps recorded for next iteration.

## Files Modified
- `docs/` (test results, baseline protocol if updated)
- `tuning_code/logs/` (logged runs; use log_evaluator)

**Parent**: [Tasks for PBI 4](./tasks.md)
