RoboAaron/Jetson-Demo-Bot-Johnny-5/docs/delivery/1/1-E2E.md

# 1-E2E E2E CoS Test

## Description
Holistic verification of all PBI CoS, including end-to-end balancing, comms, and control with physical hardware.

## Status History
- 2025-09-28: Created and set to Proposed by AI_Agent.

## Requirements
- All prior tasks Done.
- Physical tests on robot.

## Implementation Plan
- N/A (testing task).

## Test Plan
- Balancing stability test.
- Jetson comms integration.
- PS3 manual control.
- Mode blending scenarios.

## Verification
- [ ] All CoS verified.

## Files Modified
- Test logs/scripts.
