RoboAaron/Jetson-Demo-Bot-Johnny-5/docs/delivery/12/prd.md

# PBI-12: Demo 5 - Remote Teleoperation (Web/VR)

## Overview
Implement Demo 5: Remote Teleoperation so the robot can be controlled remotely via web interface or VR headset.

## Problem Statement
The robot should be controllable from remote locations for telepresence, remote operation, or VR experiences.

## User Stories
- As a user, I want to control the robot remotely via web, so that I can operate it from anywhere.
- As a user, I want VR teleoperation, so that I can have an immersive control experience.

## Technical Approach
- Create web-based teleoperation interface (ROS 2 web bridge).
- Implement VR teleoperation support (if VR hardware available).
- Stream camera feed to remote interface.
- Send control commands from remote interface to robot.
- Test teleoperation latency and responsiveness.
- Document teleoperation setup and usage.

## UX/UI Considerations
- Web interface: intuitive controls and camera feed display.
- VR interface: immersive experience with spatial awareness.
- Latency feedback: indication of network latency.

## Acceptance Criteria
- Web teleoperation interface functional.
- VR teleoperation working (if VR hardware available).
- Camera feed streams reliably to remote interface.
- Control commands sent and executed with acceptable latency (<200ms).
- Teleoperation tested in various network conditions.
- All CoS from backlog met.

## Dependencies
- ROS 2 web bridge or similar (e.g., rosbridge_suite, Foxglove).
- VR hardware (if VR features implemented).
- PBI 1 (Teensy Core Firmware) - requires robot control interface.

## Open Questions
- VR hardware: is VR headset available?
- Network requirements: what latency is acceptable?

## Related Tasks
See [Tasks for PBI 12](./tasks.md) (to be created)

**Parent Backlog**: [Backlog.md](../backlog.md)
