RoboAaron/Jetson-Demo-Bot-Johnny-5/docs/delivery/15/prd.md

# PBI-15: Demo 8 - Safety + Recovery (Fall Detection, Auto-Balance Restore)

## Overview
Implement Demo 8: Safety + Recovery so the robot can detect dangerous situations and automatically recover to safe operation.

## Problem Statement
The robot may encounter disturbances, falls, or failure modes. It needs to detect these situations and recover automatically to ensure safety and reliability.

## User Stories
- As a user, I want fall detection, so that the robot knows when it has fallen.
- As a user, I want automatic recovery, so that the robot can restore balance after disturbances.

## Technical Approach
- Implement fall detection using IMU data (rapid tilt changes, impact detection).
- Create recovery routine to restore balance after disturbance.
- Implement emergency stop procedures for various failure modes.
- Test fall detection accuracy and recovery success rate.
- Test recovery from various tilt angles and disturbances.
- Document safety procedures and recovery algorithms.

## UX/UI Considerations
- Safety status: clear indication of safety mode (normal, fall detected, recovering).
- Recovery feedback: indication of recovery progress.

## Acceptance Criteria
- Fall detection identifies falls accurately (>95%).
- Recovery routine successfully restores balance (>80% success rate).
- Emergency stop procedures work for various failure modes.
- Recovery tested from various tilt angles and disturbances.
- Safety procedures documented.
- All CoS from backlog met.

## Physical Robot Changes
- **No wiring changes required** - software-only implementation.
- **Physical testing required**: Must physically test fall detection and recovery:
  - Test fall detection with actual falls/tips (use safety precautions).
  - Test recovery from various tilt angles (manually tilt robot).
  - Test recovery from disturbances (pushes, bumps).
  - Test emergency stop procedures.
- **Safety considerations**: Testing should be done with robot secured or in safe environment to prevent damage.

## Dependencies
- PBI 1 (Teensy Core Firmware) - IMU data and balance controller.
- PBI 3 (Tip-Over Boundaries) - safety limits.
- PBI 4 (Rock-Solid Balancing) - reliable balance controller.

## Open Questions
- Fall detection thresholds: what constitutes a "fall"?
- Recovery strategy: automatic vs manual intervention required?

## Related Tasks
See [Tasks for PBI 15](./tasks.md) (to be created)

**Parent Backlog**: [Backlog.md](../backlog.md)
