RoboAaron/Jetson-Demo-Bot-Johnny-5/robotics_inventory_costs.md

# Robotics Project Inventory with Costs
_Last updated: 2025-09-03_

## Batteries
- 2x HRB 18.5 V 5000 mAh 5S 100C LiPo (XT90) — **$93.52** (#05-13488-16976)

## Connectors
- Heat Shrink Bullet Wire Connectors Kit (54 pcs, 22-10 AWG) — **$5.40** (#113-4951806-5302623)
- BOJOUL JST PH Connector Set (24 sets, assorted pins) — **$9.71** (#113-4951806-5302623)
- FLY RC 5-pairs XT90-S Anti-Spark Connectors — **$11.99** (#111-7623499-062665)
- FLY RC 2-pack XT90 Charging Cables (XT90 to 4 mm banana, 30 cm) — **$9.73** (#111-2053761-321625)

## Microcontrollers and Electronics
- PJRC Teensy 4.1 (ARM Cortex-M7, 600 MHz, iMXRT1062) — **$37.89** (#111-9274704-9389011)
- Luxonis OAK-D Pro (OAK-D-PRO-FF-C07) — **$307.86** (#12-13450-05944)
- Flipsky Dual Mini FSESC6.7 Pro 50 A Controller — **$138.87** (#02-13465-92671)
- Treedix Breakout Board with Pin Board for Teensy — **$14.58** (#111-9024809-2798611)

## Motors and Mechanical
- Aluminum Motor Mount for 6.5 in Balancing Wheel Motor Set — **$12.34** (#25-13434-67421, shipped 2025-09-02)
- Aluminum Chassis Frame Kit — **$28.67** (#14-3928471-1029471, shipped 2025-09-02)
- 6.5 in Balancing Wheel Motor Set of 2 (Gyroor, 36 V hubs) — **$50.92** (#25-13434-67421)
- Wheel Mounting Bracket Holders with Bolts — **$16.02** (#10-13480-93230)

## Power Management
- Tenergy TB-6AB Multi-Chemistry Balance Charger — **$43.29** (#113-6724513-1779436)
- RECOIL BPG4 Positive/Negative Bus Bar (150 A, 4x M8 + 4x #8) — **$21.64** (#111-0330120-6713042)
- RECOIL DS21-516 Bus Bar (48 V, 150 A, 2x M8 + 1x #8) — **$21.64** (#111-0330120-6713042)
- Nilight 90015A Heavy-Duty Battery Switch (12-48 V, waterproof) — **$15.24** (#13-5057961-2108248)
- LS2015 Carbon Fiber Survey Pole (1.8 m, 4-section mast) — **$97.41** (#13-9418307-0300237)

## Sensors and Monitors
- HiLetgo INA3221 Triple-Channel Power/Voltage Monitor (2 pcs) — **$8.65** (#113-4951806-5302623)
- Teyleten Robot GY-BNO085 IMU (9DOF AHRS) — **$20.40** (#111-9024809-2798611)

## Wires and Cables
- Electrical Wire 16 AWG Silicone (20 ft: 10ft red + 10ft black) — **$8.65** (#113-4951806-5302623)
- Electrical Wire 14 AWG Silicone (20 ft: 10ft red + 10ft black) — **$9.62** (#113-4951806-5302623)
- 12 AWG Silicone Wire (6 colors, 5 ft each) — **$19.37** (#113-4951806-5302623)
- Twidec 110-pc Battery Cable Ends (copper ring terminals + heat shrink) — **$5.41** (#111-7623499-062665)
- 10 AWG Silicone Wire 2-core (20 ft: 10ft red + 10ft black) — **$14.19** (#111-7623499-062665)

## Replacement / Protection (pending purchase)
_See [docs/hardware/recovery_wiring_guide.md](docs/hardware/recovery_wiring_guide.md) Section 2 for details._

- PJRC Teensy 4.1 (replacement) — **~$32–38**
- Teyleten Robot GY-BNO085 IMU (spare, if existing is damaged) — **~$20**
- TVS diode arrays (PRTR5V0U2X), ferrite beads, decoupling caps — **~$10**
- JST-PH 2.0 mm pre-crimped pigtails — **~$5–10**

---
**Grand Total Spent:** **$1023.01** (tax + shipping included; gift cards counted as cash)
**Pending replacement parts:** **~$67–78** (estimated)
