RoboAaron/Jetson-Demo-Bot-Johnny-5/power_wiring_diagram_ESC60A_Jetson10A_no_main_fuse.pdf

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

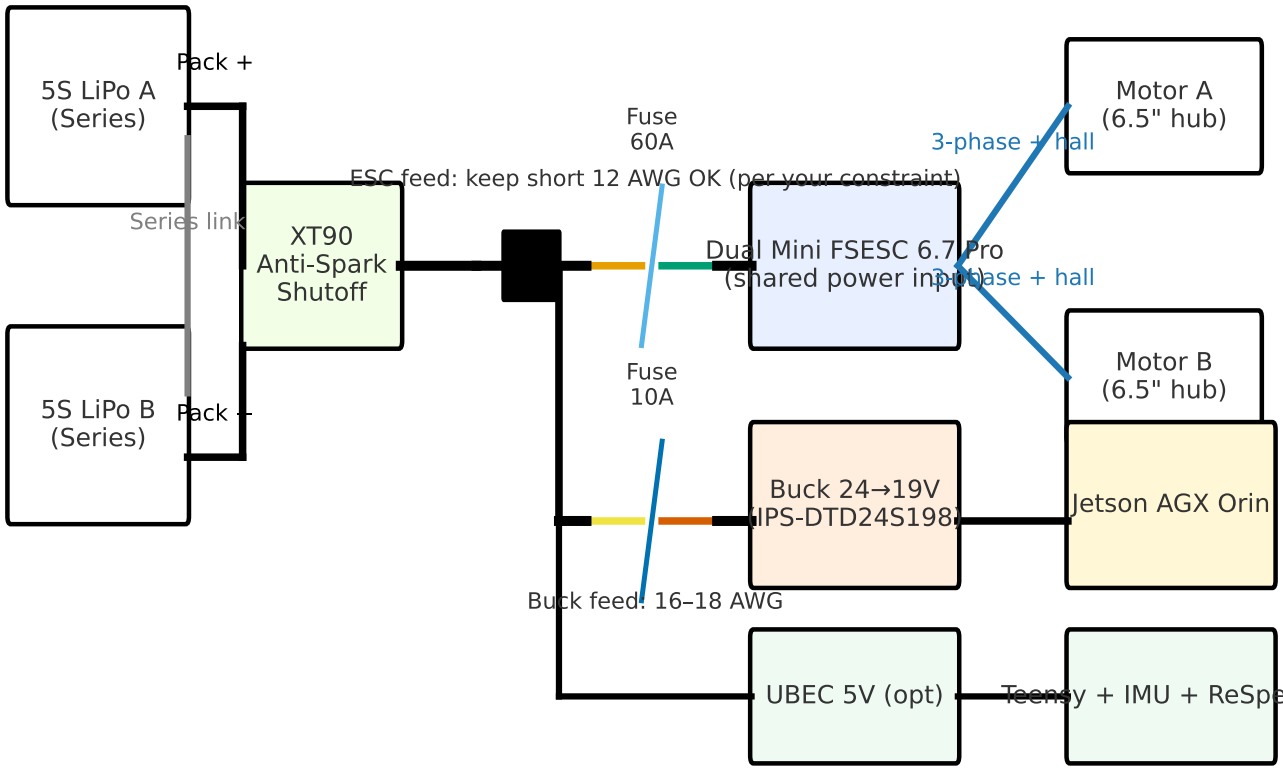
[picture p1: figure]
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
