RoboAaron/Jetson-Demo-Bot-Johnny-5/BASELINE_TEST_RESULTS.md

# Baseline Test Results - VESCs Powered

**Date:** January 2, 2025  
**Test Duration:** ~2 minutes  
**Status:** Critical Issues Identified

---

## Communication Metrics

### IMU Communication
- **Initial:** 76.9% success (20/26) - **BELOW TARGET**
- **Later:** 90.8% success (59/65) - **BELOW TARGET (95% goal)**
- **Warning:** "IMU not responding! Last update: 110 ms ago"
- **Status:** ⚠️ **NEEDS IMPROVEMENT**

### VESC Communication
- **First 5 seconds:** 24.0% success (6/25) - **CRITICAL FAILURE**
- **After 1 minute:** 18.8% success (12/64) - **CRITICAL FAILURE**
- **Status:** ❌ **CRITICAL - System cannot function with this failure rate**

---

## Critical Issues Identified

### Issue #1: VESC Communication Failures (CRITICAL)

**Evidence:**
- Only 18-24% success rate (target: >90%)
- System cannot get reliable velocity feedback
- Position tracking completely broken

**Impact:**
- Velocity readings are extreme and wrong (104-131 m/s = 200+ mph - impossible!)
- Position integration drifts wildly (0 to 370+ meters)
- PID control is reacting to bad data

**Root Cause:**
- Likely EMI interference from motors
- Serial communication failing when motors active
- May need hardware fixes (ferrite beads, twisted wires)

### Issue #2: IMU Communication Degraded

**Evidence:**
- Started at 76.9% (poor)
- Improved to 90.8% (better, but still below 95% target)
- Warning: "IMU not responding! Last update: 110 ms ago"

**Impact:**
- Intermittent sensor updates
- Control loop may miss critical data

**Root Cause:**
- Likely EMI interference
- I2C at 400kHz may be too fast for current wiring
- May need hardware fixes

### Issue #3: Velocity Data Completely Wrong

**Evidence:**
- VelAct values: 104.16, 130.73, 131.50 m/s (impossible - robot would be at 200+ mph!)
- Position drifting: 0 → 370+ meters (robot hasn't moved that far)
- Data persists even when robot should be stationary

**Root Cause:**
- VESC communication failures → bad velocity data
- Position integration using bad velocity → wild drift
- System trying to control based on completely wrong feedback

---

## System Behavior Analysis

### What's Working
- ✅ System initializes correctly
- ✅ IMU initializes at 0x4B
- ✅ VESCs initialize
- ✅ PID controllers initialize
- ✅ No Teensy resets (rate limiting fixed that)
- ✅ Logging system working

### What's Not Working
- ❌ VESC communication: 18-24% success (needs >90%)
- ❌ IMU communication: 76-91% success (needs >95%)
- ❌ Velocity feedback: Completely unreliable
- ❌ Position tracking: Wildly inaccurate
- ❌ Balance testing: Cannot test due to bad data

---

## Immediate Actions Required

### Priority 1: Fix VESC Communication (CRITICAL)

**Hardware Fixes (Required):**
1. **Add ferrite beads** to Serial1/Serial2 wires (TX/RX)
2. **Twist Serial wires** (TX/RX pairs)
3. **Add decoupling capacitors** (0.1µF + 10µF on Teensy power)
4. **Check grounding** (single point, thick wires)

**Software Adjustments:**
1. **Increase VESC interval** to 20ms (50Hz) - press 'u' key
2. **Reduce baud rate** to 57600 (more noise-tolerant)
3. **Add timeout handling** to prevent blocking

### Priority 2: Improve IMU Communication

**Hardware Fixes:**
1. **Add ferrite beads** to I2C wires (SDA/SCL)
2. **Twist I2C wires** (SDA/SCL pair)
3. **Reduce I2C speed** to 200kHz (press 'q' key)

**Software Adjustments:**
1. **Reduce I2C speed** to 200kHz (more noise-tolerant)
2. **Monitor for improvements**

---

## Recommendations

### Immediate (Before Next Test)
1. **Implement hardware fixes:**
   - Ferrite beads on all signal wires
   - Twist all signal wire pairs
   - Add decoupling capacitors

2. **Software adjustments:**
   - Increase VESC interval to 20ms
   - Reduce I2C speed to 200kHz
   - Consider reducing baud rate to 57600

### Short-term (After Hardware Fixes)
1. **Retest with hardware fixes**
2. **Target metrics:**
   - VESC: >90% success
   - IMU: >95% success
   - Velocity: Reasonable values (-5 to +5 m/s)

3. **If still failing:**
   - Check serial wiring (TX/RX might be swapped)
   - Verify VESC power connections
   - Consider optocouplers for isolation

---

## Next Steps

1. **Implement hardware fixes** (ferrite beads, twisted wires, capacitors)
2. **Adjust software settings** (increase VESC interval, reduce I2C speed)
3. **Retest** and measure improvements
4. **Compare results** to baseline
5. **Proceed to balance testing** once communication is stable

---

## Conclusion

The baseline test confirms:
- ✅ System architecture is correct
- ✅ Software optimizations are working
- ❌ **Hardware EMI mitigation is REQUIRED**
- ❌ **Cannot proceed to balance testing until VESC communication is fixed**

**The 18-24% VESC communication failure rate is a blocker.** Hardware fixes are not optional - they are required for the system to function.
