RoboAaron/Jetson-Demo-Bot-Johnny-5/BASELINE_TEST_RESULTS_V2.md

# Baseline Test Results - VESCs Powered (After Ground Fix)

**Date:** January 2, 2025  
**Test Duration:** ~5+ minutes  
**Status:** ✅ **COMMUNICATION EXCELLENT** - Ready for PID Tuning

---

## Critical Fix Applied

**Issue:** No shared ground between Teensy and VESCs  
**Fix:** Added shared ground connection  
**Result:** Communication success rates improved dramatically

---

## Communication Metrics (AFTER GROUND FIX)

### IMU Communication ✅ EXCELLENT
- **Initial:** 96.4% success (81/84)
- **After 1 minute:** 98.9% success (267/270)
- **After 3 minutes:** 99.3% success (453/456)
- **After 5 minutes:** 99.6% success (639/642)
- **Final:** 99.6% success (825/828)
- **Status:** ✅ **EXCEEDS TARGET (>95%)**

### VESC Communication ✅ EXCELLENT
- **Initial:** 94.0% success (78/83)
- **After 1 minute:** 98.1% success (264/269)
- **After 3 minutes:** 98.9% success (450/455)
- **After 5 minutes:** 99.2% success (636/641)
- **Final:** 99.4% success (822/827)
- **Status:** ✅ **EXCEEDS TARGET (>90%)**

---

## System Performance

### Velocity Data ✅ RELIABLE
- **Range:** -5 to +5 m/s (reasonable values)
- **No extreme values** (previously saw 104-131 m/s)
- **Status:** ✅ **Data quality excellent**

### Position Tracking ✅ FUNCTIONAL
- **Tracking:** 0 → 10+ meters (robot is moving on stand)
- **No wild drift** (previously saw 0→370+ meters when stationary)
- **Status:** ✅ **Working correctly**

### Motor Behavior ⚠️ NEEDS TUNING
- **Observation:** Motors moving "too aggressively"
- **Root Cause:** PID gains too high (not communication issue)
- **Status:** ⚠️ **Ready for PID tuning**

---

## Comparison: Before vs After Ground Fix

| Metric | Before (No Ground) | After (Shared Ground) | Improvement |
|---|---|---|---|
| VESC Success | 18-24% | 98-99% | **+75-80%** ✅ |
| IMU Success | 76-91% | 99-100% | **+8-23%** ✅ |
| Velocity Data | Extreme (104-131 m/s) | Reasonable (-5 to +5 m/s) | **Fixed** ✅ |
| Position Tracking | Wild drift (370+ m) | Normal tracking | **Fixed** ✅ |
| System Status | Cannot function | Ready for tuning | **Operational** ✅ |

---

## Key Findings

### ✅ What's Working
1. **VESC communication:** 98-99% success (excellent)
2. **IMU communication:** 99-100% success (excellent)
3. **Velocity feedback:** Reliable and reasonable
4. **Position tracking:** Working correctly
5. **System stability:** No resets, stable operation
6. **Ground connection:** Critical fix resolved all communication issues

### ⚠️ What Needs Tuning
1. **Motor aggressiveness:** PID gains too high
   - Reduce Kp_angle (currently 15.0)
   - Reduce Kp_vel (currently 0.8)
   - May need to reduce maxCurrent (currently 8.0A)

---

## Next Steps

### Immediate: PID Tuning
1. **Reduce angle PID gains:**
   - Press 'p' to reduce Kp_angle (try 10.0 or 12.0)
   - Press 'd' to reduce Kd_angle (try 0.5 or 0.6)

2. **Reduce velocity PID gains:**
   - Press 'P' to reduce Kp_vel (try 0.5 or 0.6)
   - Current Kd_vel = 0.15 is good (velocity damping working)

3. **Reduce max current:**
   - Press 'm' to reduce maxCurrent (try 5.0A or 6.0A)

4. **Test on floor** once motors are less aggressive

### Short-term: Balance Testing
- Once PID tuned, proceed to balance attempts
- Target: 70-85% success rate
- Monitor communication (should stay >95%)

---

## Conclusion

**The shared ground fix was the solution!** Communication is now excellent:
- ✅ VESC: 98-99% success
- ✅ IMU: 99-100% success
- ✅ System is operational and ready for PID tuning

**No hardware fixes needed** (ferrite beads, twisted wires, etc.) - the ground connection was the critical missing piece.

---

**Test Status:** ✅ **SUCCESS** - Communication issues resolved  
**Next Phase:** PID tuning for smoother motor control
