RoboAaron/Jetson-Demo-Bot-Johnny-5/TESTING_OPTIMIZED_I2C.md

# Testing Optimized I2C Firmware

**Status**: IMU Working - Ready for Testing  
**Target**: 70-85% Reliability (vs 30-40% baseline)

---

## Current Configuration

✅ **I2C Speed**: 400kHz (Fast Mode)  
✅ **IMU Update Rate**: 400Hz  
✅ **PID Update Rate**: 500Hz (2ms sample time)  
✅ **Velocity Damping**: Kd_vel = 0.15 (enabled)  
✅ **IMU Working**: Confirmed

---

## Testing Steps

### Step 1: Baseline Test (If Not Already Done)

**Record baseline performance**:
- Success rate: ___% (should be ~30-40%)
- Motor chattering: Present / Absent
- Typical balance duration: ___ seconds
- Notes: ________________

### Step 2: Test Optimized Firmware

**Upload**: `teensy_balance_logging_i2c_optimized/teensy_balance_logging_i2c_optimized.ino`

**Verify Configuration** (check serial monitor):
- I2C Clock: 400 kHz ✓
- IMU Update Rate: 400 Hz ✓
- PID Update Rate: 500 Hz ✓
- Velocity Kd: 0.15 ✓

### Step 3: Test Balance Performance

**Test Protocol**:
1. Start robot from rest position
2. Attempt to balance for 30+ seconds
3. Record result: **Success** (30+ seconds) or **Failure** (falls before 30s)
4. Repeat **20-50 times** for statistical significance
5. Calculate success rate: (Successes / Total) × 100%

**What to Observe**:
- ✅ **Motor chattering**: Should be eliminated (Kd_vel = 0.15)
- ✅ **Response speed**: Should feel faster/more responsive
- ✅ **Stability**: Should be more stable, less oscillation
- ✅ **Balance duration**: Should consistently reach 30+ seconds

### Step 4: Record Results

**Performance Metrics**:
- **Success Rate**: ___% (target: 70-85%)
- **Motor Chattering**: Eliminated / Still Present
- **Typical Balance Duration**: ___ seconds
- **Improvement**: +___% over baseline

**Comparison**:
| Metric | Baseline | Optimized | Improvement |
|---|---|---|---|
| Success Rate | 30-40% | ___% | +___% |
| Motor Chattering | Present | ___ | ___ |
| Balance Duration | 10-30s | ___s | ___s |

---

## What to Look For

### ✅ Success Indicators

1. **Motor Chattering Eliminated**
   - Motors should run smoothly
   - No rapid on/off switching
   - Smooth corrections

2. **Faster Response**
   - Robot responds quicker to disturbances
   - Less lag between tilt and correction
   - More "alive" feeling

3. **Better Stability**
   - Less oscillation
   - Holds position better
   - Recovers from small pushes more reliably

4. **Higher Success Rate**
   - 70-85% of attempts succeed for 30+ seconds
   - Consistent performance across multiple attempts

### ⚠️ Issues to Watch For

1. **Still Chattering**
   - May need to increase Kd_vel (try 0.20 or 0.25)
   - Use 'K' key to increase velocity damping live

2. **Too Aggressive**
   - Robot overcorrects
   - Oscillates wildly
   - May need to reduce Kp_angle or Kd_angle

3. **Still Low Success Rate**
   - If <70%, may need PID tuning
   - Or may need sensor fusion (next phase)
   - Or may need to try 1MHz I2C (if supported)

---

## Live Tuning Commands

While testing, you can tune parameters live:

**Velocity Damping (Kd_vel)**:
- `k` - Decrease Kd_vel (less damping)
- `K` - Increase Kd_vel (more damping)

**Angle PID**:
- `p/P` - Decrease/Increase Kp_angle
- `i/I` - Decrease/Increase Ki_angle
- `d/D` - Decrease/Increase Kd_angle

**Velocity PID**:
- `a/A` - Decrease/Increase Kp_vel
- `b/B` - Decrease/Increase Ki_vel

**Show Settings**:
- `x` - Show all current settings

---

## Expected Results

### Conservative Estimate
- **Success Rate**: 60-75% (moderate improvement)
- **Motor Chattering**: Eliminated
- **Balance Duration**: 20-40 seconds typically

### Target (Based on Analysis)
- **Success Rate**: 70-85% (significant improvement)
- **Motor Chattering**: Eliminated
- **Balance Duration**: 30+ seconds consistently

### Best Case
- **Success Rate**: 80-90% (if everything works perfectly)
- **Motor Chattering**: Eliminated
- **Balance Duration**: 60+ seconds possible

---

## Next Steps Based on Results

### If Target Achieved (70-85% reliability)
1. ✅ **Proceed to Phase 2**: Advanced control (LQR, adaptive control)
2. ✅ **Fine-tune PID gains** for optimized I2C
3. ✅ **Consider sensor fusion** for additional 10-15% gain

### If Below Target (<70% reliability)
1. **Try 1MHz I2C**: If Teensy supports Fast Mode Plus
2. **Fine-tune PID**: May need adjustment for higher rates
3. **Check update rates**: Verify 400Hz is actually running
4. **Consider sensor fusion**: May help reach target

### If Above Target (>85% reliability)
1. ✅ **Excellent!** You've exceeded expectations
2. ✅ **Proceed to Phase 2** for even better performance
3. ✅ **Consider SPI upgrade** only if needed for final 5-10% gain

---

## Testing Checklist

- [ ] Upload optimized firmware
- [ ] Verify IMU is working (400Hz updates)
- [ ] Verify configuration (400kHz I2C, 400Hz IMU, 500Hz PID)
- [ ] Test balance performance (20-50 attempts)
- [ ] Record success rate
- [ ] Verify motor chattering eliminated
- [ ] Compare to baseline metrics
- [ ] Document results

---

**Status**: Ready for testing  
**Expected Improvement**: +30-50% reliability gain  
**Time Required**: 30-60 minutes of testing
