RoboAaron/Jetson-Demo-Bot-Johnny-5/teensy_balance_single_loop/READINESS_EVALUATION.md

# Readiness Evaluation - Robot Balance Performance

## Log Analysis: `robot_log_20260123_173438.txt`

### ✅ Balance Performance (EXCELLENT)

**Roll Stability:**
- Roll angle: **-0.25° to -0.7°** (target: -0.7°)
- Error: **0.0° to 0.5°** (very small!)
- **Status**: ✅ **PASS** - Robot maintains balance within ±0.5° of target

**Motor Current:**
- Current range: **-1.0A to +1.0A** (when active)
- Many values at **0.0A** (within deadband/minCurrent threshold)
- **Status**: ✅ **PASS** - Smooth, controlled motor commands

**Response to Disturbances:**
- Robot corrects smoothly when roll deviates
- No wild oscillations observed
- **Status**: ✅ **PASS** - Responsive and stable

**IMU Communication:**
- IMU: **391-393 Hz (97.7-98.8% success rate)**
- **Status**: ✅ **PASS** - Excellent communication reliability

**Overall Balance Assessment:**
- ✅ **Robot balances on stand** - YES (consistently)
- ✅ **Responds to disturbances** - YES (smooth corrections)
- ✅ **No wild oscillations** - YES (roll varies ±0.5°)
- ✅ **Smooth motor response** - YES (current changes smoothly)
- ✅ **Correct direction** - YES (roll error → appropriate current)

**VERDICT**: ✅ **READY FOR VELOCITY CONTROL**

---

### ❌ Yaw Control Issues (NEEDS FIXING)

**Problem Identified:**
- Yaw PID gains showing as **`-nan`** (corrupted values)
- Yaw Output: **Always 0.00A** (PID not computing)
- Yaw Error: **-11° to -16°** (significant, but no correction)
- Cannot adjust yaw values (stays as `-nan`)

**Root Cause:**
- EEPROM contains corrupted yaw PID values
- When loaded, they become `nan`
- PID library can't compute with `nan` gains
- Adjusting `nan + 0.5` still equals `nan`

**Fix Applied:**
- Added validation in `loadSettings()` to detect and reset corrupted values
- Added validation in `setup()` to ensure values are valid
- Added validation in tuning commands to reset if corrupted
- Default values: Kp_yaw=0.5, Ki_yaw=0.0, Kd_yaw=0.1

**Action Required:**
1. Re-upload firmware (fixes will auto-reset corrupted values)
2. Test yaw control adjustment (should work now)
3. Tune yaw PID if needed (start with defaults)

---

## Readiness Checklist Results

### Must Have (Required) - ✅ ALL PASS

1. ✅ **Robot balances on stand** - YES (30+ seconds, roll ±0.5°)
2. ✅ **Responds to disturbances** - YES (smooth corrections in 1-2 seconds)
3. ✅ **No wild oscillations** - YES (roll varies ±0.5°, no chattering)
4. ✅ **Smooth motor response** - YES (current changes smoothly, no rapid switching)
5. ✅ **Correct direction** - YES (roll error → appropriate current direction)

### Should Have (Recommended) - ✅ ALL PASS

6. ✅ **Recovers from large tilts** - YES (log shows smooth recovery)
7. ✅ **Stable current when balanced** - YES (0.0A when within deadband)
8. ✅ **Minimal overshoot** - YES (roll stays within ±0.5°)

### Nice to Have (Optional) - ⚠️ PARTIAL

9. ⚠️ **Works on floor** - NOT TESTED (but balance is stable enough)
10. ❌ **Handles yaw rotation** - NO (yaw control not working due to corrupted values)

---

## Performance Metrics

| Metric | Target | Actual | Status |
|---|---|---|---|
| **Roll Stability** | ±2° | ±0.5° | ✅ EXCELLENT |
| **Roll Error** | <1° | 0.0-0.5° | ✅ EXCELLENT |
| **Motor Current** | <3A | -1.0 to +1.0A | ✅ EXCELLENT |
| **IMU Success Rate** | >95% | 97.7-98.8% | ✅ EXCELLENT |
| **Response Time** | <3s | 1-2s | ✅ EXCELLENT |
| **Oscillations** | None | None | ✅ EXCELLENT |

---

## Recommendations

### Immediate Actions

1. **Fix Yaw Control** (15 minutes)
   - Re-upload firmware (auto-fixes corrupted values)
   - Test yaw PID adjustment (should work now)
   - Tune yaw PID if robot rotates (start with defaults)

2. **Proceed to Velocity Control** (Ready Now!)
   - Balance is excellent
   - All readiness criteria met
   - Can start Phase 1 (Velocity Control Loop)

### Yaw Control Tuning (After Fix)

**If robot rotates:**
- Start with defaults: Kp_yaw=0.5, Ki_yaw=0.0, Kd_yaw=0.1
- Increase Kp_yaw if rotation persists (try 0.7, 1.0, 1.5)
- Add Ki_yaw if robot drifts (start with 0.05, increase gradually)
- Adjust Kd_yaw for stability (0.1-0.3 typically)

**If robot doesn't rotate:**
- Yaw control may not be needed (robot is stable)
- Can disable with `n` command or set gains to 0

---

## Conclusion

**Balance Performance**: ✅ **EXCELLENT** - Ready for velocity control  
**Yaw Control**: ❌ **BROKEN** - Needs firmware fix (corrupted EEPROM values)

**Overall Status**: ✅ **READY TO PROCEED** with velocity control implementation. Yaw control can be fixed and tuned in parallel or after velocity control is working.

**Next Step**: Re-upload firmware to fix yaw control, then proceed with Phase 1 (Velocity Control Loop) from `POSITION_VELOCITY_CONTROL_PLAN.md`.
