RoboAaron/Jetson-Demo-Bot-Johnny-5/(commit log)

2025-09-04 Initial commit: Jetson Demo Bot (Johnny 5) documentation and project files
    [robotics_inventory_costs.csv]
2025-09-04 Add comprehensive development setup for Teensy and FSESC
    - Updated software_extensions.md with detailed Teensy and FSESC tools
    - Created setup_windows_dev.bat for automated Windows installation
    - Added setup_teensy_dev.md with complete Teensy 4.1 setup guide
    - Added setup_fsesc_config.md with FSESC6.7 Pro configuration guide
    - Created test_installations.py to verify development environment
    - Installed Arduino IDE, PuTTY, and Python packages via winget
2026-02-11 Add ROS2 infrastructure packages: description, bringup, sensor fusion, and Gazebo sim
    - johnny5_description: Modular xacro URDF with chassis, wheels, sensors (IMU,
    LiDAR, OAK-D camera), mast, proper inertials, and complete TF tree
    (base_footprint -> base_link -> chassis/wheels/imu_link/laser/camera_link)
    - johnny5_bringup: Master launch files for robot hardware (robot.launch.py),
    sensor drivers, SLAM Toolbox, and Nav2 navigation with tuned configs
    - johnny5_sensor_fusion: EKF configuration fusing wheel odometry + BNO085 IMU
    via robot_localization, ready for both hardware and simulation
    - johnny5_gazebo: Indoor test world (8x6m room with obstacles) and Gazebo
    launch with diff_drive,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
    [chassis.urdf.xacro, gazebo.urdf.xacro, johnny5.urdf.xacro, robot_params.yaml, sensors.urdf.xacro, wheels.urdf.xacro]
2026-02-11 Fix URDF dimensions from photos, add Gazebo stabilizers, update configs
    Corrected robot dimensions using 8x8" base plate as reference:
    - wheel_separation: 0.50 -> 0.30m (estimated from motor mount offsets)
    - chassis: 0.35x0.30x0.20 -> 0.203x0.203x0.28m (3 plates, 10-12" tall)
    - chassis_z_offset: 0.02 -> 0.14m (centered in taller chassis)
    - camera_z: 1.27 -> 1.63m (recalculated from new chassis height + mast)
    - imu_z: 0.12 -> 0.22m (near top plate of 3-plate stack)
    - robot_radius: 0.30 -> 0.22m in Nav2 costmaps
    - Added mast_y_offset for side-mounted mast bracket (per photos)
    Added invisible frictionless stabilizer spheres for Gazebo sim (use_sim
    only) to prevent the two-wheeled robot from ti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
    [chassis.urdf.xacro, gazebo.urdf.xacro, johnny5.urdf.xacro, robot_params.yaml]
2026-02-11 Add project TODO with drill template task and pending measurements
    Tracks the key next steps: creating a drill layout for the final
    aluminum base plates from the current prototype, plus all [TENTATIVE]
    dimension measurements that need hardware verification.
    https://claude.ai/code/session_01G5mLqXmgaVQSMU8RGYon1Q
2026-02-11 Add Teensy balance firmware skeleton and design documentation
    Establishes the Phase 2 firmware foundation:
    - firmware/FIRMWARE_DESIGN.md: documents all design decisions including
    the BNO085 vs BNO055 discrepancy (wrong library in setup guide), VESC
    CAN protocol choices (current control, FlexCAN_T4), PID architecture
    (D-on-measurement, anti-windup), and hardware validation checklist.
    - firmware/teensy_balance/ (PlatformIO project):
    - platformio.ini: Teensy 4.1, SparkFun BNO08x, FlexCAN_T4 deps
    - config.h: all tunable constants and pin definitions
    - imu_bno085.h/.cpp: BNO085 wrapper using ARVR rotation vector report
    - vesc_can.h/.cpp: VESC open CAN protocol (SET_CURRENT + STATUS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
2026-02-11 Correct all artifacts to reflect actual firmware on feature/spi-migration
    Previous commits on this branch were based on master, which contains only
    documentation with no firmware. The real development branch is
    feature/spi-migration, which has 80+ commits of working firmware.
    FIRMWARE_DESIGN.md: completely rewritten with accurate findings —
    actual architecture (Adafruit_BNO08x + VescUart + PID_v1.h), real
    decisions made (I2C kept over SPI, UART over CAN, cascaded PID),
    current stability baseline (30-40% success rate, 30+ sec runs,
    14Hz chattering), and path to 99% reliability (tasks 4-2 through 4-6).
    firmware/teensy_balance/: removed — was a speculative skeleton built
    on wrong assumpti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
2026-02-12 Refactor serial layer into shared TeensyComms module; add Jetson bridge
    Extract SerialReader from robot_tuning_gui.py into tuning_code/teensy_comms.py
    (TeensyComms class) as a GUI-independent shared module. The GUI is refactored
    to import TeensyComms and use on_disconnect / on_mode_change callbacks instead
    of tight GUI coupling.
    Add Jetson-specific code:
    jetson/jetson_bridge.py — standalone bridge with safety watchdog
    and auto-reconnect; usable without ROS
    jetson/ros2/balance_bridge_node.py — ROS 2 node subscribing /cmd_vel,
    publishing /imu/* and /robot_state
    Protocol decision: reuse the existing 20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
    [balance_bridge_node.py, robot_tuning_gui.py, teensy_comms.py]
2026-02-12 Add Jetson #VEL command parser to Teensy firmware; fix prefix collision
    The 'J:' prefix conflicted with the existing 'j'/'J' single-char Kd command.
    Changed to '#' (unused in the tuning CLI) throughout.
    Firmware changes (teensy_balance_cascaded.ino):
    • Serial read loop: detect '#' with Serial.peek() and call
    handleJetsonCommand(String) instead of the single-char switch
    • New handleJetsonCommand(): parses '#VEL=<m/s>,STEER=<rad/s>'
    and updates velocitySetpoint + jetsonSteerRads
    • 20 Hz velocity PID block: integrates jetsonSteerRads (rad/s) into
    yawSetpoint (degrees) each tick; zeroes steer if command is stale
    (>600 ms) for a firmware-side safety backstop
    • New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
    [teensy_balance_cascaded.ino, teensy_comms.py]
2026-02-12 Add ROS 2 ament_python package scaffold and offline unit tests
    ROS 2 package (jetson/ros2/):
    balance_bridge/
    __init__.py — sys.path bootstrap (source-tree + colcon install)
    balance_bridge_node.py — node code (moved from top-level, same API)
    balance_bridge_node.py — backward-compat shim pointing to the package
    package.xml — ament_python, rclpy / geometry_msgs / std_msgs deps
    setup.py / setup.cfg — colcon build config, console_scripts entry point
    resource/balance_bridge — ament resource index marker
    launch/balance_bridge.launch.py — launch with device/watchdog_s/publish_rate_hz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
2026-02-12 Add PBI-5 demo prioritization roadmap (docs/delivery/5/tasks.md)
    Completes PBI-5 CoS: dependency analysis, hardware gap identification,
    and prioritized 4-wave implementation sequence for demos PBIs 8-15.
    Key findings:
    • PBI-3 (tip-over auto-stop) already done — firmware stops at ±25°
    • ReSpeaker mic NOT in inventory — audio demos (PBI-10, 14) blocked
    • LDROBOT lidar implied on-hand (package already in repo) — confirms PBI-16 viable
    • VR path for PBI-12 skipped — web-only teleoperation is sufficient
    Wave sequence:
    0 — Foundation: balance stability, /odom, colcon build smoke-test
    1 — Quick wins: Safety+Recovery (PBI-15), Remote Teleoperation (PBI-12)
    2 —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
2026-02-13 Update PBI-5 roadmap: ReSpeaker + ESP32 purchases close all hardware gates
    Hardware changes (2026-02-13):
    • ReSpeaker purchased → PBI-10 (ASR/LLM) moved Wave 4 → Wave 2B (parallel track)
    PBI-14 (wake word) moved Wave 4 → Wave 3
    • ESP32 purchased → PBI-1 task 1-4 redesigned: ESP32 bridges PS3 BT → USB serial
    → Jetson joy_node → teleop_twist_joy (no custom PS3 driver needed)
    • twist_mux added to Wave 0 foundation: joy > nav2 > web > voice priority
    Result: zero remaining hardware purchase gates across all 11 demos.
    Audio demos now parallel with navigation infrastructure in Wave 2.
    https://claude.ai/code/session_01AAM6jJP3PoPnWLeDwywV1Q
2026-02-13 Wave 0 foundation: /odom publisher, ESP32 PS3 bridge, twist_mux, esp32_joy_node
    balance_bridge_node.py:
    • Add nav_msgs/Odometry publisher on /odom (dead-reckoning: encoder vel + IMU yaw)
    • Add tf2_ros TransformBroadcaster publishing odom → base_link TF at 20 Hz
    • Odometry method: theta taken directly from BNO085 yaw (no heading drift);
    x/y integrated via v*cos(θ)*dt / v*sin(θ)*dt; conservative diagonal covariance
    esp32/ps3_bridge/ps3_bridge.ino (new):
    • ESP32 Arduino firmware using ps3Controller library
    • Pairs PS3 DualShock via Bluetooth; streams 20 Hz JSON over USB serial
    • Format: {"lx","ly","rx","ry", buttons..., "connected":0|1}
    • Includes pairing in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
    [balance_bridge_node.py, esp32_joy_node.py, ps3_bridge.ino]
2026-02-16 Add #VEL patch file for feature/spi-migration
    firmware/patches/vel-command-spi-migration.patch contains the complete
    git-apply-compatible diff to add the Jetson #VEL=<m/s>,STEER=<rad/s>
    command parser to the spi-migration firmware.
    Protected branches (main, feature/spi-migration) cannot be pushed from
    this session. Apply the patch manually:
    git checkout feature/spi-migration
    git apply firmware/patches/vel-command-spi-migration.patch
    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
2026-02-17 Integration: main + feature/spi-migration (non-SPI); include VescUart.zip and SPI_WIRING_GUIDE.md
2026-02-17 Improve log evaluator for disturbance-aware PID tuning
2026-02-17 Document velocity sign verified and how deadband thrashing is fixed
2026-02-26 Cascaded: useVelocityLoop, deadband/filter, angle PID defaults; GUI v/6/V and evaluator fixes
    Made-with: Cursor
    [log_evaluator.py, robot_tuning_gui.py, teensy_balance_cascaded.ino, teensy_comms.py]
2026-03-12 4-2 Add cascaded single-loop parity mode and velocity loop status.
    Add a parity path that matches single-loop actuation when velocity and yaw are off, surface velocity-loop ON/OFF state in the GUI, and document the A/B isolation strategy for debugging cascaded instability against a single-loop baseline.
2026-03-12 4-2 Add angle-only VESC bypass, dry-run motor toggle, and cascaded bring-up plan.
    Implement true angle-only mode by bypassing VESC feedback when velocity loop is off, add motor output dry-run toggle ('o') with GUI status/toggle support, and document the validated parity result plus staged bring-up plan to transition back to full cascaded control.
2026-03-12 4-2 Clarify active cascaded plan and archive superseded guidance.
    Label the current parity-validated bring-up flow as authoritative and mark older planning docs as archived/superseded to prevent mixing outdated tuning steps with the active recovery path.
2026-03-12 Single-loop defaults/LPF/direction; tuning README; log_evaluator and comms for RawVel/VelSet
    - teensy_balance_single_loop: tuned PID defaults (Kp=2,Ki=0,Kd=0.04), angle LPF (angleFilterAlpha), per-motor direction signs, maxCurrent=3.5/minCurrent=0.1, EEPROM magic bump and auto-save defaults, k for save
    - tuning_code/README: cascaded as primary firmware, Linux start/serial steps, clearer usage and log_evaluator reference
    - log_evaluator: parse RawVel/VelSet, raw vs filtered velocity analysis for cascaded logs
    - teensy_comms: support cascaded serial format (RawVel, etc.) and fallback for older format
    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
2026-03-13 Kd step 0.01/0.002, toggle status refresh, Motor Output parse; add test checklist
    Firmware:
    - KD_STEP_COARSE 0.05 -> 0.01 so Kd steps by 0.01 without Fine Adjust
    - Motor output toggle prints 'Motor Output: ENABLED/DISABLED' for GUI parse
    GUI:
    - Add 'o'/'O' to command names (Toggle Motor Output)
    - Schedule immediate update_display when use_vel_loop, yaw_control_enabled,
    motor_output_enabled, or fine_adjust is parsed so status labels stay in sync
    TUNING_RECOMMENDATIONS:
    - Add 'What to test now' checklist: reflash, GUI toggles, Kd steps, optional parity run
    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
2026-03-13 TUNING: 5c chatter note — log had Kp=2.0 for most of run; focus maxCurrent and Kd
    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
2026-03-16 Target JetPack 6 / Ubuntu 22.04 (Jammy) for ROS 2 Humble bundle
    - build_j5_bundle.sh: focal→jammy, ubuntu:20.04→22.04; simplify Docker
    script (Humble debs available on Jammy arm64); add manylinux_2_28
    for pip wheels; update README and fail messages
    - jetson_headless_guide.md: JetPack 6.x, Ubuntu 22.04, jammy apt
    source, ubuntu:22.04 Docker; note CUDA 12.6 for faster-whisper
    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
2026-03-17 Jetson setup: verify script fixes and host helpers
    - build_j5_bundle.sh: fix 08_verify_install.sh
    - set +u when sourcing ROS to avoid unbound AMENT_* vars
    - pipe-safe package/topic checks (PKGS/TOPICS vars) to avoid
    BrokenPipeError when grep exits early
    - verify_bundle.sh: host-side bundle verification script
    - scripts/run_j5_bundle_on_jetson.sh: helper to run bundle scripts on Jetson
    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
2026-03-18 Jetson setup: LiDAR/OAK-D bundle fixes, in-place update script, sensor test docs
    - build_j5_bundle.sh: patch ld19.launch.py (port_name=/dev/ldlidar), enable
    depthai-ros in 04 (set +u, rm COLCON_IGNORE), update README note
    - scripts/update_bundle_jetson_setup.sh: in-place bundle update without
    redownload (LiDAR tarball patch + overwrite 04 script)
    - docs/delivery/JETSON_SETUP_CURRENT_STATE.md: current Jetson/bundle state,
    verify 08 results, quick reference
    - docs/delivery/SENSOR_TESTS_AND_DEMOS_TASKS.md: full task list for
    individual/joint sensor tests and demos
    - docs/delivery/SENSOR_TESTS_PROMPT_EXPORT.md: copy-paste prompts for
    Claude/ChatGPT to generate sensor test and demo inst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
2026-04-08 Teensy cascaded balance: 500Hz angle PID ISR, IMU gyro drain, fix setup/ISR corruption
    - IntervalTimer ISR for angle PID; restore void setup() separated from ISR
    - SH2_GYROSCOPE_CALIBRATED enable + gyroPitchRate; volatile yaw/roll IMU globals
    - Remove unused lastMotorWrite; fix outputCurrent in ISR; single loop() definition
    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
    [teensy_balance_cascaded.ino]
2026-04-17 4-7 Balance recovery: EEPROM reset, zero-mean dither, per-second gain log line
    Field log robot_log_20260415_222218.txt showed ~8° sustained lean with
    RollOut only ±0.04-1.7 A — math only works if in-RAM gains were much
    lower than source claims (EEPROM shadow). Fix:
    1. SETTINGS_MAGIC 0xC45C4DEE -> 0xC45C4DEF forces loadSettings()
    to return false so code defaults take effect on next boot.
    SavedSettings struct layout unchanged.
    2. Source defaults set to known-good starting point: Kp=5.0, Ki=0.0,
    Kd=0.03, baseSetpoint=-1.60 (natural CG from log analysis),
    maxCurrent=5.0 (safe authority).
    3. applyStictionComp() replaced with applyDither(): ±0.08 A sinusoid
    at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
    [teensy_balance_cascaded.ino]
2026-04-17 4-7 done; 4-8 open: PID state reset + logic validation
    4-7 verified against field log robot_log_20260416_223241.txt — magic
    bump forced source defaults, dither replaced stiction comp,
    per-second GAINS: line is streaming, printTuningValues() prints
    dither. Moved InProgress -> Done.
    4-8 opened for the PID_v1.Initialize() DC-bias latching bug
    discovered during 4-7 verification. GUI screenshot showed RollOut
    pinned at +2.0 A (= maxCurrent) for >10 minutes at |err| < 0.02°
    with Ki=0 and no I-term to decay. Root cause confirmed from
    Arduino PID library source: Initialize() snapshots *myOutput into
    outputSum on every MANUAL -> AUTOMATIC, and with Ki=0, P_ON_E,
    outputSum never changes in Compute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
2026-04-17 4-8 fix PID_v1 Initialize() DC-bias latching + PID logic audit
    Root cause: PID_v1::SetMode(AUTOMATIC) calls Initialize(), which
    snapshots *myOutput into outputSum. With Ki=0 and P_ON_E, Compute()
    never updates outputSum — so any non-zero value latched on a
    MANUAL->AUTOMATIC transition becomes a permanent DC bias on the
    output. Observed as RollOut pinned at +maxCurrent for >10 minutes
    at |err| < 0.02° in the 2026-04-16 stand test screenshot.
    Fix:
    - Add static inline rearmBalancePID() / rearmVelocityPID() /
    rearmYawPID() helpers that zero the output double (and snap the
    input pointer for bumpless transfer) before SetMode(AUTOMATIC).
    - Replace every SetMode(AUTOMATIC) call site for the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
    [teensy_balance_cascaded.ino]
2026-04-17 docs: balance tuning roadmap + proposed tasks 4-9 to 4-11
    - BALANCE_TUNING_ROADMAP.md: phases A-F, CLI-first tuning steps, log refs
    - 4-9 gyro-rate D-term, 4-10 surface retune/plant ID, 4-11 GUI performance
    - tasks.md: index rows + roadmap link + history (231027 vs 232745)
    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
2026-04-17 PBI-4: field-tuned defaults, SETTINGS_MAGIC bump, backlog + 4-8 Review
    Firmware (teensy_balance_cascaded.ino):
    - SETTINGS_MAGIC 0xC45C4DEF -> 0xC45C4DF0 so EEPROM invalid loads
    proven inner-loop defaults from robot_log_20260416_232745.txt:
    Kp=1.5, Kd=0.06, Ki=0, baseSetpoint=-0.84 deg,
    angleFilterAlpha=0.25, maxCurrent=2.0 A (cardboard/low-traction).
    - loadSettings invalid alpha fallback 0.15 -> 0.25 to match.
    Delivery:
    - 4-8.md: InProgress -> Review, verification notes from field logs.
    - tasks.md: 4-8 status Review; history line for defaults commit.
    - backlog.md: PBI 4 CoS updated (4-2 Review, 4-7/4-8, roadmap link,
    continuation 4-9..4-11); History + Notes.
    - BALANCE_TUNING_ROADMAP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
2026-04-29 docs: refresh README and add hardware recovery/setup guides
    Update the root README to reflect the consolidated main-branch architecture and current balance milestone, and add recovery/setup documentation for damaged-controller replacement and FSESC configuration with inventory follow-ups.
    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
2026-04-29 chore: ignore jetson/SD_CARD_DUMP/ in version control
    Local bundle artifact directory (4+ GB) should never be committed.
    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
2026-04-29 tuning GUI: add VEL_SCALE, min current controls, remap yaw toggle
    - Add VEL_SCALE parameter with n/N keys for IMU velocity estimator scale
    - Add Min Current control with q/Q keys and parsing patterns
    - Change yaw toggle from n/N to f/F (key conflict resolution)
    - Add @ command for syncing GUI with firmware parameters
    - Update help text to reflect all changes
    Note: Requires matching firmware support for new commands.
    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
2026-04-29 add sensor test scripts, launch file, and documentation (UNTESTED)
    Move sensor test artifacts from staging to proper locations:
    Scripts (scripts/):
    - sensor_check_hardware.sh — hardware-level sensor detection (no ROS)
    - sensor_check_ros.sh — ROS topic verification
    Launch (johnny5_bringup/launch/):
    - sensor_test.launch.py — sensor-only launch for integration testing
    Documentation (docs/testing/):
    - sensor_test_checklist.md — printable test checklist
    - sensor_tests_execution_guide.md — detailed step-by-step guide
    - demo_01_balance.md — balance demo runbook
    - demo_03_slam.md — SLAM demo runbook
    - CURSOR_EXECUTION_GUIDE.md — AI assistant execution reference
    WARNING: These hav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
2026-04-29 fix: prevent continuous PID rearming by tracking balance state transitions
    [teensy_balance_cascaded.ino]
